prashnts/limn/notebooks/cell-test/cell-runs.png

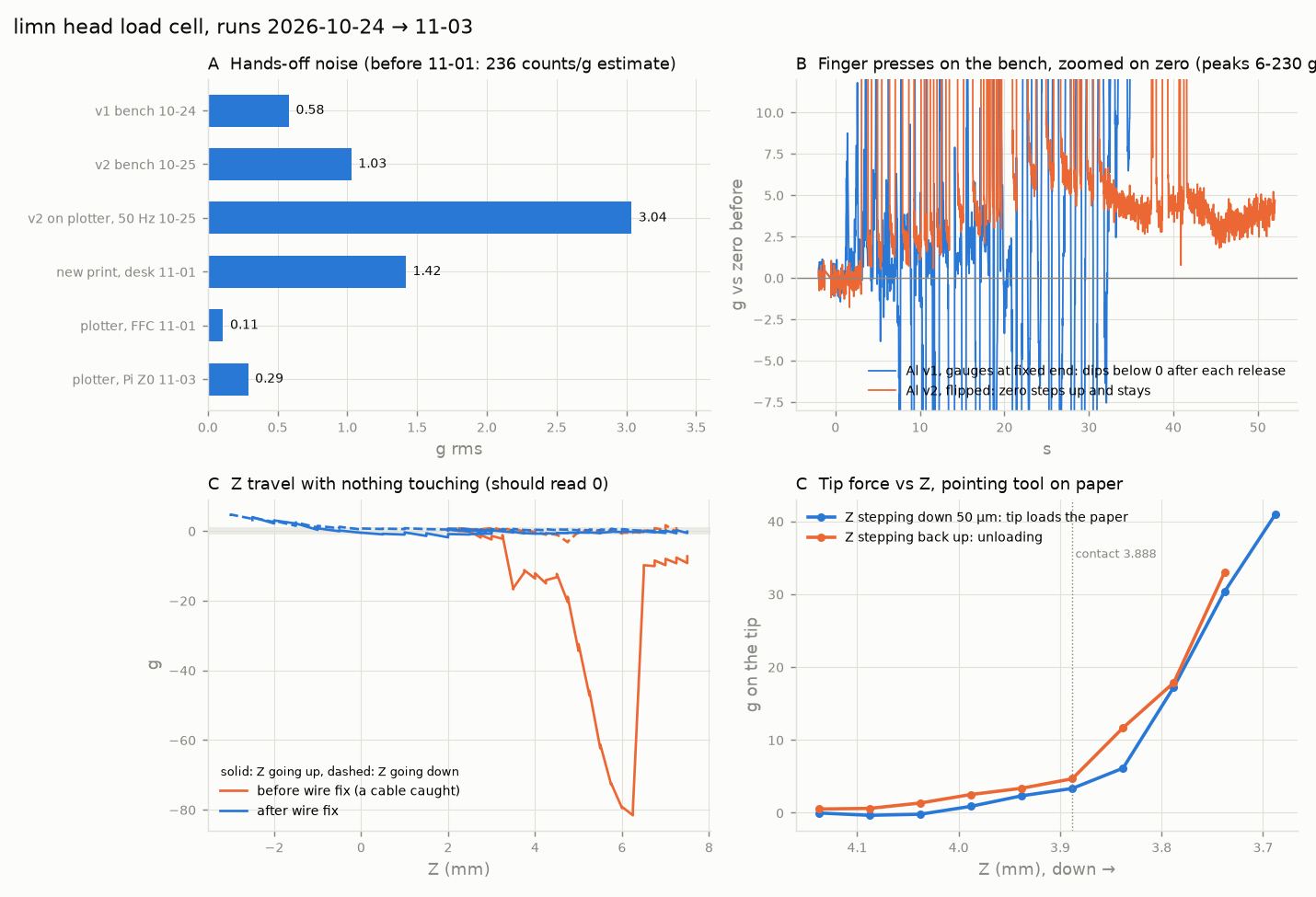
notebooks/cell-test/cell-runs.png
