prashnts/limn/docs/kicad/limn.kicad_pcb

## KiCad design docs/kicad/limn.kicad_pcb (2026-11-08)

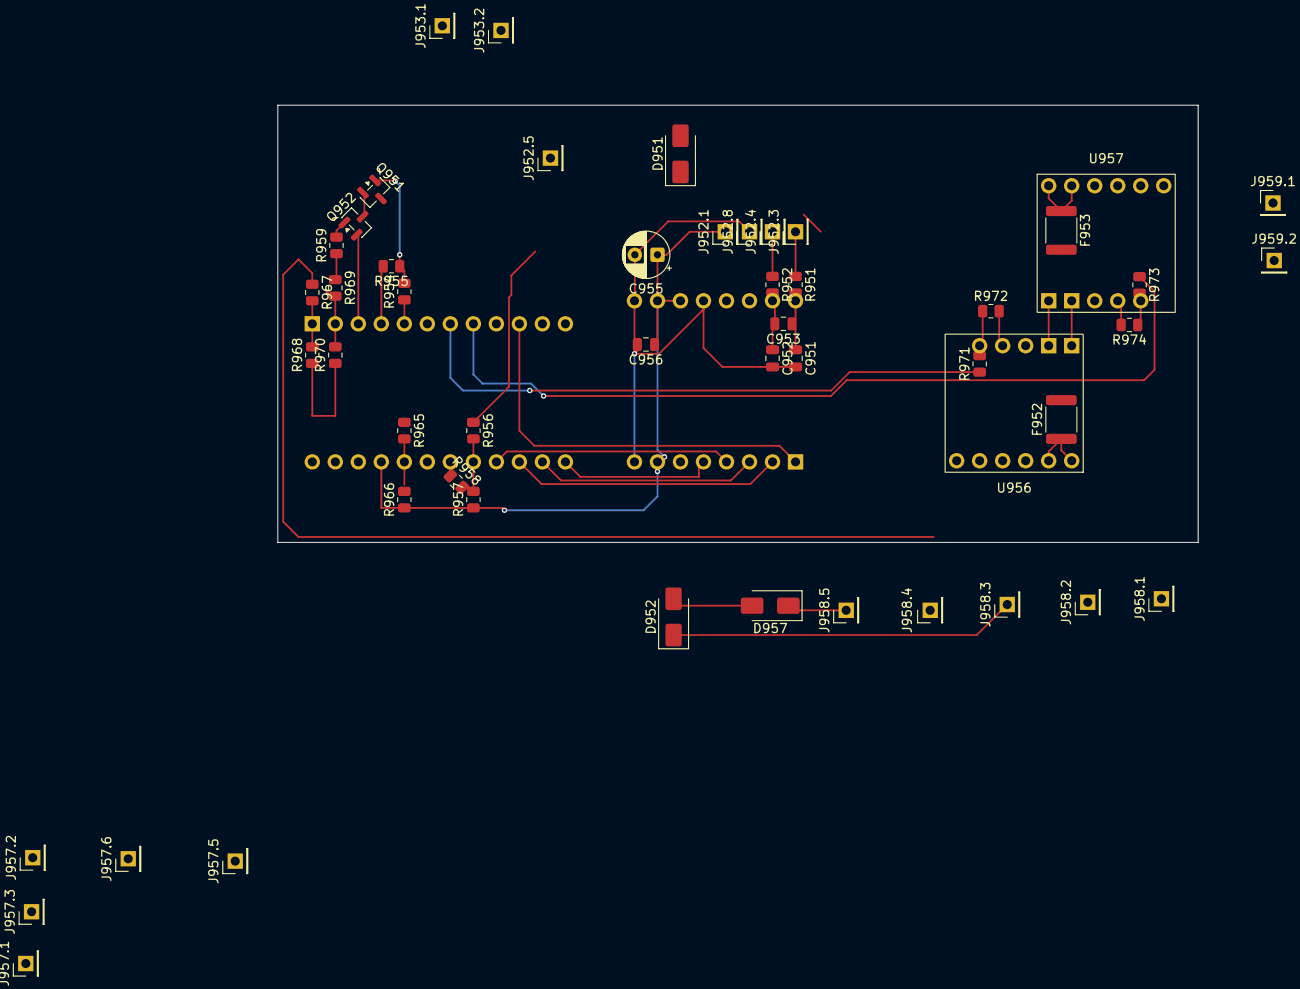
[picture p15: board limn.kicad_pcb from above]

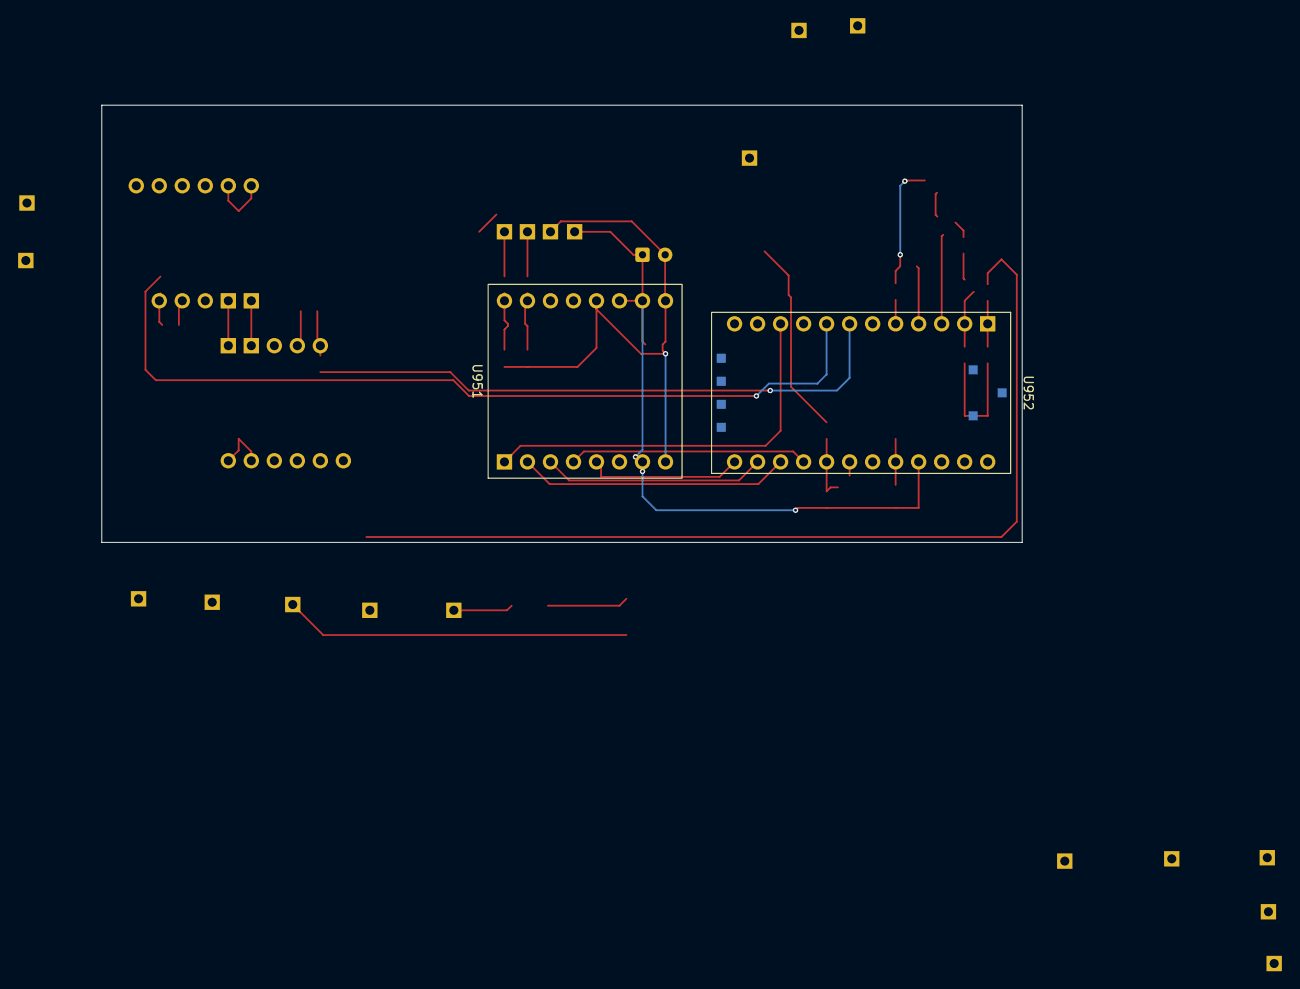
[picture p16: board limn.kicad_pcb from below]

Board: 2 copper layers, 101.6 x 48.3 mm, 53 parts (2 on the bottom side), 37 nets.

Parts:
C951, C952: 4n7 C0G; C_0805_2012Metric
C953: 47n; C_0805_2012Metric
C955: 47u; CP_Radial_D5.0mm_P2.50mm
C956: 100n; C_0805_2012Metric
D951, D952, D957: SMAJ3.3A; D_SMA
F952, F953: PPTC 1812 1A 6V; Fuse_1812_4532Metric
J952.1: CAT6 1; PinHeader_1x01_P2.54mm_Vertical
J952.3: CAT6 3; PinHeader_1x01_P2.54mm_Vertical
J952.4: CAT6 4; PinHeader_1x01_P2.54mm_Vertical
J952.5: CAT6 5; PinHeader_1x01_P2.54mm_Vertical
J952.8: CAT6 8; PinHeader_1x01_P2.54mm_Vertical
J953.1: to the Melzi (EXT A4) 1; PinHeader_1x01_P2.54mm_Vertical
J953.2: to the Melzi (EXT A4) 2; PinHeader_1x01_P2.54mm_Vertical
J957.1: to the hub board (J1002) 1; PinHeader_1x01_P2.54mm_Vertical
J957.2: to the hub board (J1002) 2; PinHeader_1x01_P2.54mm_Vertical
J957.3: to the hub board (J1002) 3; PinHeader_1x01_P2.54mm_Vertical
J957.5: to the hub board (J1002) 5; PinHeader_1x01_P2.54mm_Vertical
J957.6: to the hub board (J1002) 6; PinHeader_1x01_P2.54mm_Vertical
J958.1: to the bed dock (pogo) 1; PinHeader_1x01_P2.54mm_Vertical
J958.2: to the bed dock (pogo) 2; PinHeader_1x01_P2.54mm_Vertical
J958.3: to the bed dock (pogo) 3; PinHeader_1x01_P2.54mm_Vertical
J958.4: to the bed dock (pogo) 4; PinHeader_1x01_P2.54mm_Vertical
J958.5: to the bed dock (pogo) 5; PinHeader_1x01_P2.54mm_Vertical
J959.1: +5V Toolchanger USB 1; PinHeader_1x01_P2.54mm_Vertical
J959.2: +5V Toolchanger USB 2; PinHeader_1x01_P2.54mm_Vertical
Q951: MMBT3904 / BC847 (SOT-23); SOT-23
Q952: AO3400; SOT-23
R951, R952, R958, R959, R971, R973: 1k; R_0805_2012Metric
R954, R968: 4k7; R_0805_2012Metric
R955, R972, R974: 100k; R_0805_2012Metric
R956, R965, R967, R969: 100R; R_0805_2012Metric
R957, R966, R970: 10k; R_0805_2012Metric
U951: ADS1220 module (the sum chip); ADS1220_module
U952: SparkFun Pro Micro RP2040 (top view, USB-C up); SparkFun_Pro_Micro_RP2040
U956, U957: Pololu mini slide sw. #2810; Pololu_Mini_MOSFET_Slide_Switch

Connections:
+3V3_PH: C955.1, C956.1, J952.1.1, R957.1, R966.1, R968.1, R970.1, U951.7 (DVDD), U951.10 (AVDD), U951.11 (REFP0), U952.16 (3V3)
+5V_HUB: J957.1.1, U952.13 (RAW)
+5V_SW: F953.2, J959.1.1
+5V_TOOL_IN: J957.5.1, U956.1 (VIN), U957.1 (VIN)
/Plot bed board/AIN_N: C952.1, C953.2, R952.2, U951.15 (AIN1)
/Plot bed board/AIN_P: C951.1, C953.1, R951.2, U951.16 (AIN0)
/Plot bed board/CIPO: U951.2 (MISO), U952.22 (GP20/CIPO)
/Plot bed board/COPI: U951.3 (MOSI), U952.23 (GP23/COPI)
/Plot bed board/CS2: U951.5 (CS), U952.24 (GP21/CS)
/Plot bed board/DRDY2: U951.1 (DRDY), U952.10 (GP7)
/Plot bed board/ID_PU: R958.1, U952.19 (GP27/A1)
/Plot bed board/SCK: U951.4 (SCLK), U952.21 (GP22/SCK)
/Plot bed board/SIG_N: J952.4.1, R952.1
/Plot bed board/SIG_P: J952.3.1, R951.1
/Plot bed board/TOOL_ID_IN: R956.2, R957.2, R958.2, U952.20 (GP26/A0)
/Plot bed board/TOUCH_GP: R954.1, U952.5 (GP2)
BED_DATA: J958.4.1, R967.1
BED_DETECT: D952.1 (A1), J958.3.1, R965.1
BED_DET_IN: R965.2, R966.2, U952.17 (GP29/A3)
BED_EN: R971.1, U952.7 (GP4)
BED_IO: R967.2, R968.2, U952.1 (GP0/TX)
BED_PROBE: D957.1 (A1), J958.5.1, R959.1, R969.1
BED_PROBE_IN: R969.2, R970.2, U952.2 (GP1/RX)
BED_PWR: F952.2, J958.1.1
GND: C951.2, C952.2, C955.2, C956.2, D951.2 (A2), D952.2 (A2), D957.2 (A2), J952.8.1, J953.2.1, J957.6.1, J958.2.1, J959.2.1, Q952.2 (S), R955.2, R972.2, R974.2, U951.8 (DGND), U951.9 (AGND), U951.12 (REFN0), U952.3 (GND), U952.4 (GND), U952.14 (GND), U956.3 (GND), U957.3 (GND)
unnamed: Q951.1 (B), R954.2, R955.1
unnamed: Q951.2 (E), Q952.3 (D)
unnamed: Q952.1 (G), R959.2
unnamed: R971.2, R972.1, U956.2 (ON)
unnamed: F952.1, U956.4 (VOUT)
unnamed: R973.2, R974.1, U957.2 (ON)
unnamed: F953.1, U957.4 (VOUT)
PM_USB_DN: J957.3.1, U952.31 (D-)
PM_USB_DP: J957.2.1, U952.30 (D+)
PROBE_A4: J953.1.1, Q951.3 (C)
SW_5V_EN: R973.1, U952.8 (GP5)
TOOL_ID: D951.1 (A1), J952.5.1, R956.1
