prashnts/limn/docs/kicad/toolhead_board.kicad_pcb

## KiCad design docs/kicad/toolhead_board.kicad_pcb (2026-11-05)

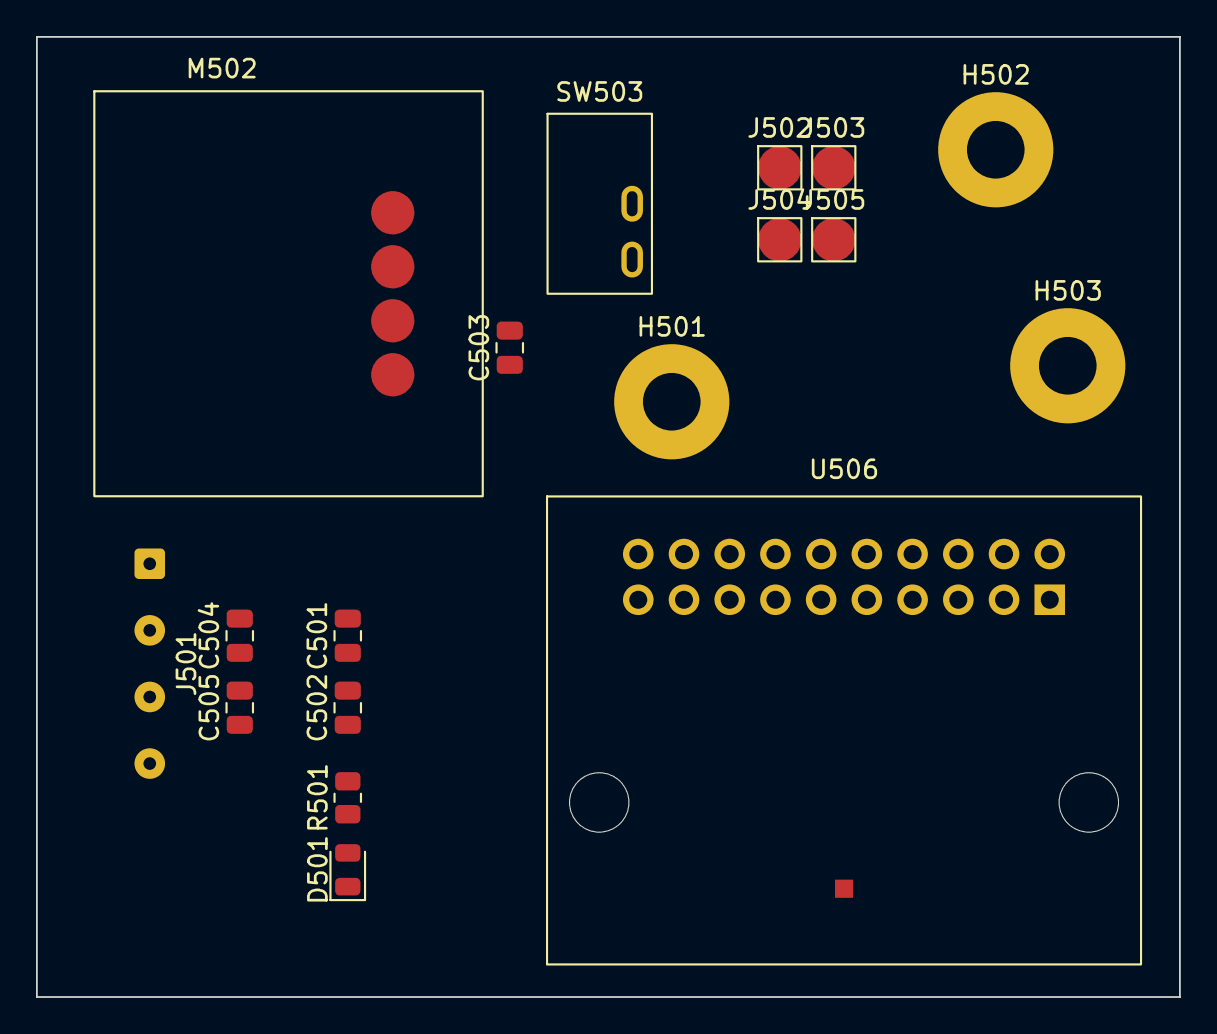
[picture p17: board toolhead_board.kicad_pcb from above]

Board: 2 copper layers, 63.5 x 53.3 mm, 18 parts (0 on the bottom side), 15 nets, no tracks yet.

Parts:
C501: 10u; C_0805_2012Metric
C502, C505: 100n; C_0805_2012Metric
C503: 10n; C_0805_2012Metric
C504: 10n C0G; C_0805_2012Metric
D501: LED yellow; LED_0805_2012Metric
H501: screw right, 5V; MountingHole_3.2mm_M3_Pad
H502: screw left, GND; MountingHole_3.2mm_M3_Pad
H503: screw top, ID; MountingHole_3.2mm_M3_Pad
J501: cell pads; SolderWire-0.127sqmm_1x04_P3.7mm_D0.48mm_OD1mm
J502, J503, J504, J505: pogo; Pogo_pin_D2.0_L5.0
M502: 10 mm linear micro stepper (K, the key lock); Stepper_slider_5mm_flex4
R501: 4k7; R_0805_2012Metric
SW503: key switch (K); Micro_limit_sw_inline
U506: FPC-20P breakout (head); FPC20_breakout

Connections:
+5V_TOOL: C501.1, C502.1, H501.1, R501.1, U506.13, U506.14, U506.15
CELL_EXC_N: C505.2, J501.4, U506.5
CELL_EXC_P: C505.1, J501.1, U506.2
CELL_SIG_N: C504.2, J501.3, U506.4
CELL_SIG_P: C504.1, J501.2, U506.3
ENDSTOP_K: C503.1, SW503.1, U506.7
GND: C501.2, C502.2, C503.2, D501.1, H502.1, J504.1, SW503.2, U506.1, U506.6, U506.8, U506.11, U506.16
MOT_K_1A: M502.1, U506.17
MOT_K_1B: M502.2, U506.18
MOT_K_2A: M502.3, U506.19
MOT_K_2B: M502.4, U506.20
unnamed: D501.2, R501.2
TOOL_ID: H503.1, J505.1, U506.12
TOOL_USB_DN: J503.1, U506.10
TOOL_USB_DP: J502.1, U506.9
