prashnts/limn/docs/kicad/aux_board.kicad_pcb

## KiCad design docs/kicad/aux_board.kicad_pcb (2026-10-24)

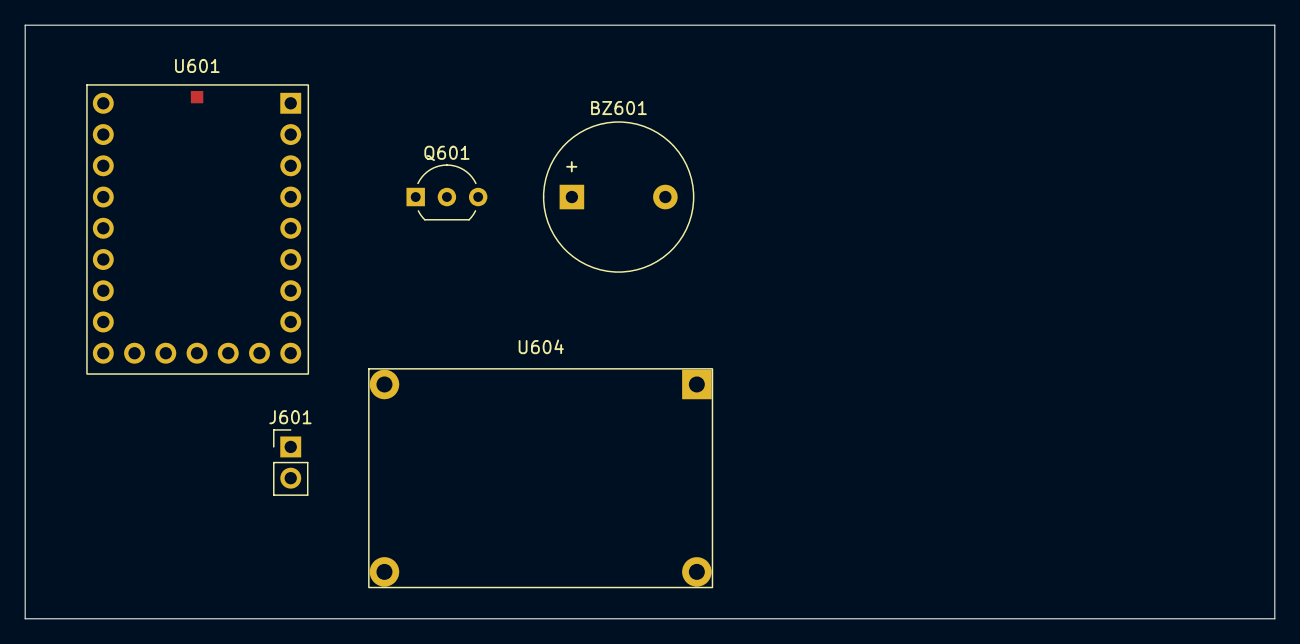
[picture p18: board aux_board.kicad_pcb from above]

Board: 2 copper layers, 101.6 x 48.3 mm, 5 parts (0 on the bottom side), 5 nets, no tracks yet.

Parts:
BZ601: buzzer; Buzzer_12x9.5RM7.6
J601: 9 V in (Trigger1); PinHeader_1x02_P2.54mm_Vertical
Q601: 2N7000; TO-92_Inline_Wide
U601: RP2040-Zero (rpi); Waveshare_RP2040_Zero
U604: MP1495 5 V (MP_Buck0); Mini_buck_3A

Connections:
+5V_LED: BZ601.1, U601.23, U604.3
+9V: J601.1, U604.1
GND: J601.2, Q601.1, U601.22, U604.2, U604.4
unnamed: BZ601.2, Q601.3
unnamed: Q601.2, U601.10
