prashnts/limn/docs/kicad/beam_bed_board.kicad_pcb

## KiCad design docs/kicad/beam_bed_board.kicad_pcb (2026-10-24)

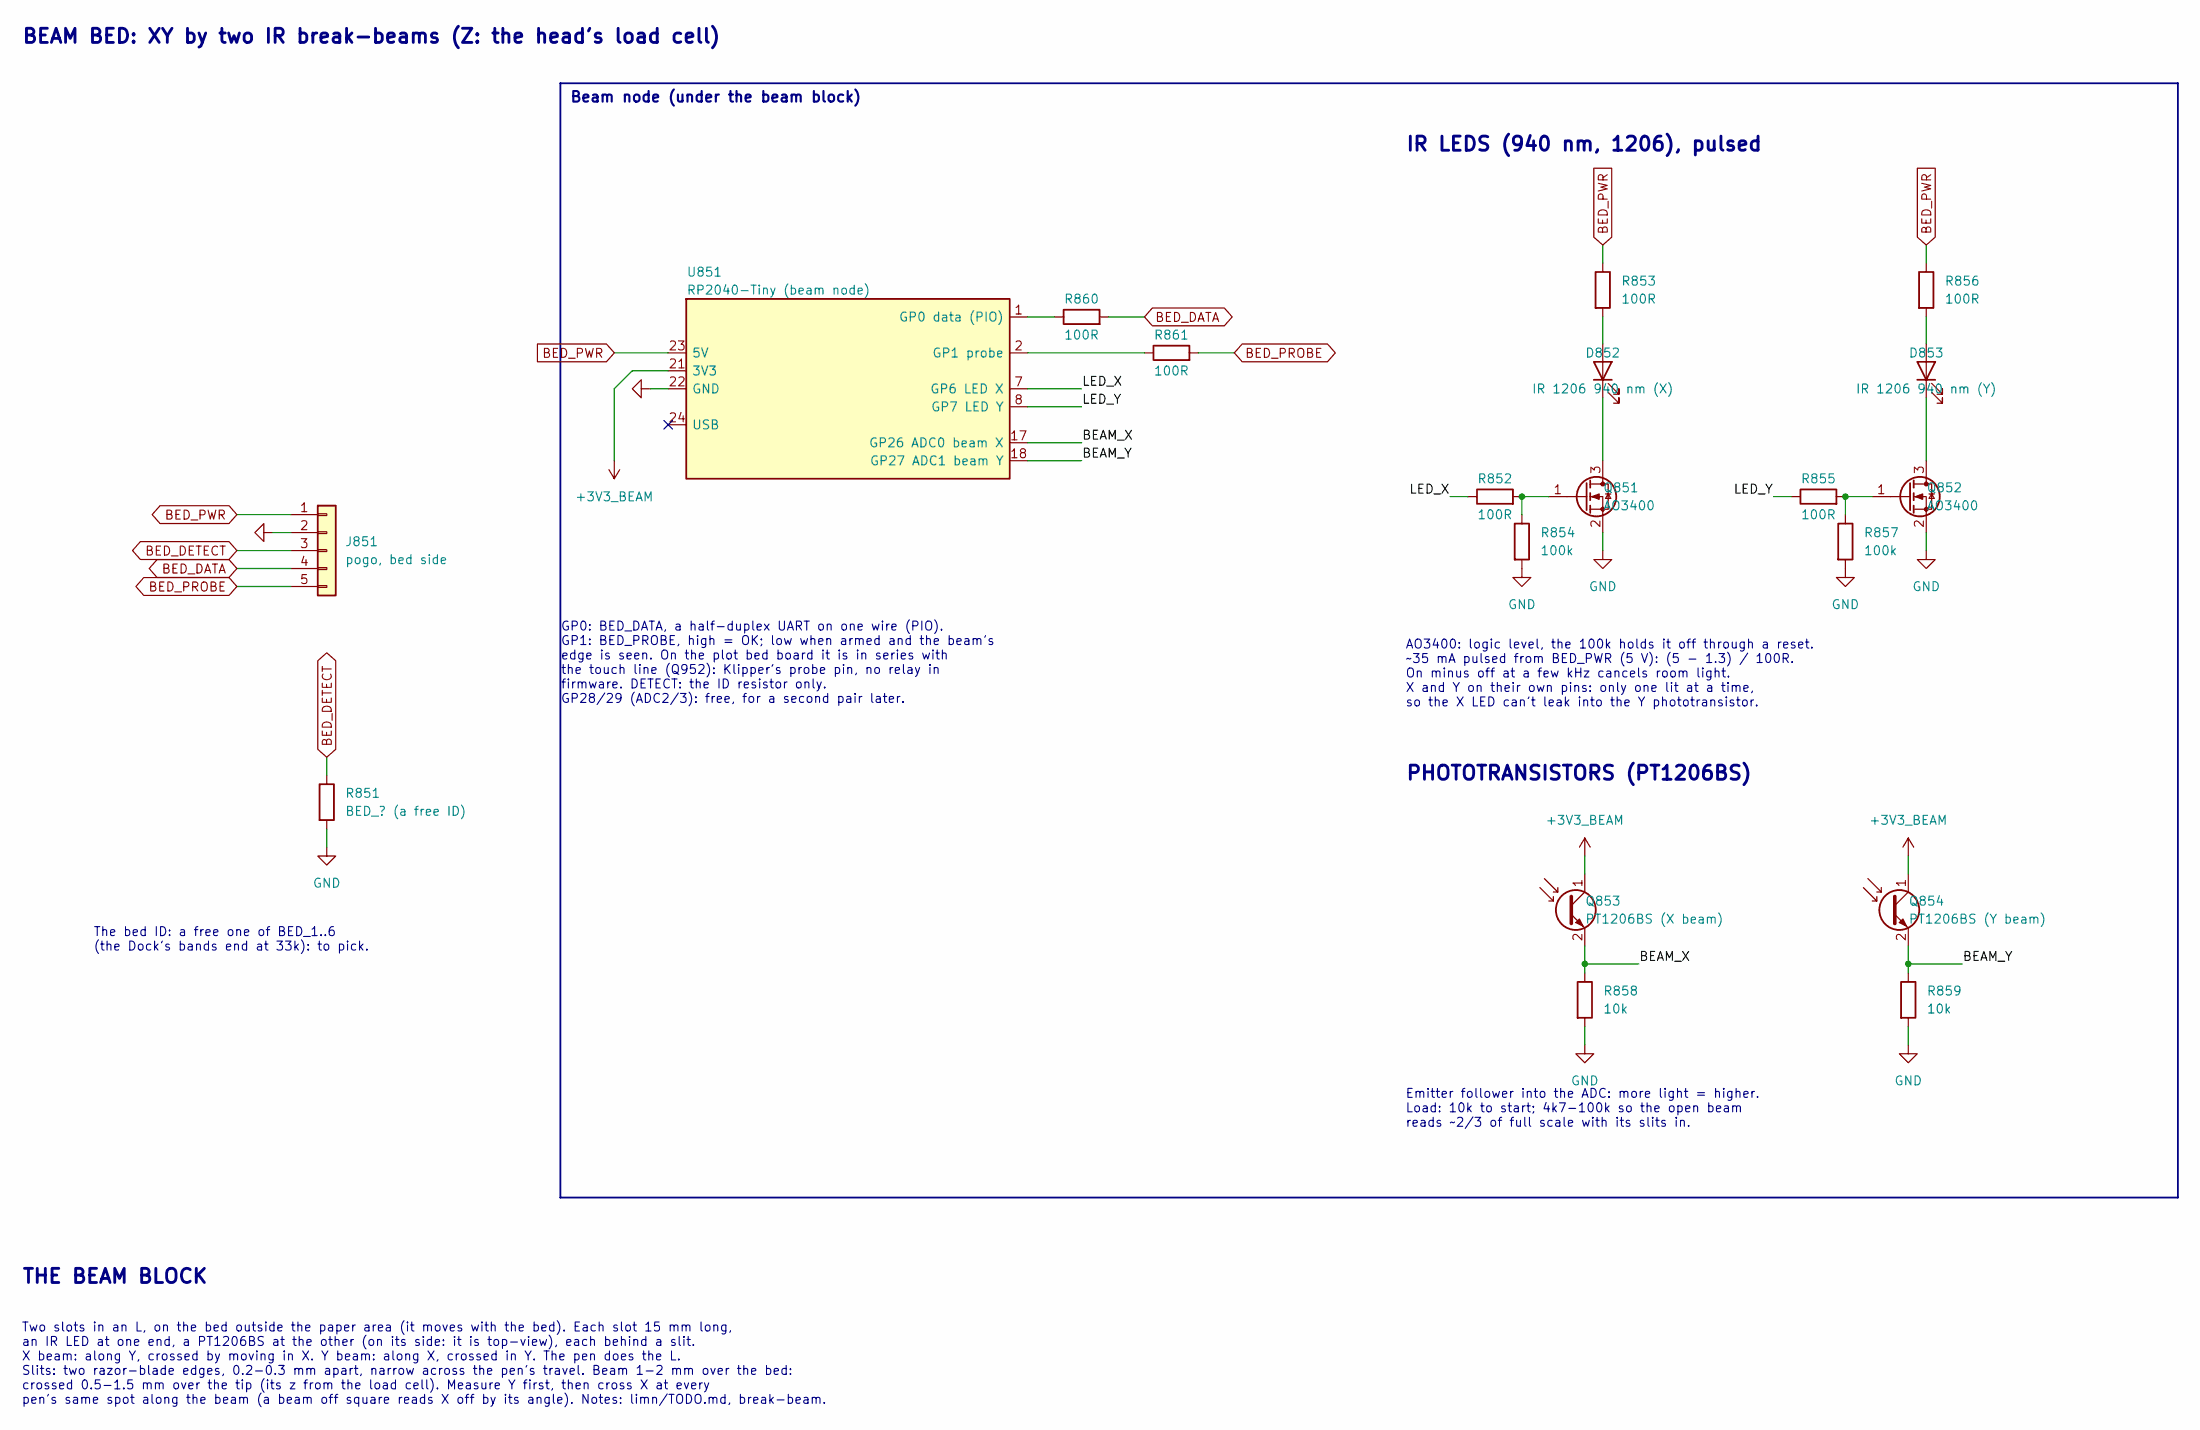
[picture p19: schematic beam_bed.kicad_sch, Limn: the beam bed, XY by two IR break-beams]

Parts:
D852: IR 1206 940 nm (X); LED_1206_3216Metric
D853: IR 1206 940 nm (Y); LED_1206_3216Metric
J851: pogo, bed side; PinHeader_1x05_P2.54mm_Vertical
Q851, Q852: AO3400; SOT-23
Q853: PT1206BS (X beam); LED_1206_3216Metric
Q854: PT1206BS (Y beam); LED_1206_3216Metric
R851: BED_? (a free ID); R_0805_2012Metric
R852, R853, R855, R856, R860, R861: 100R; R_0805_2012Metric
R854, R857: 100k; R_0805_2012Metric
R858, R859: 10k; R_0805_2012Metric
U851: RP2040-Tiny (beam node); Waveshare_RP2040_Tiny

Connections:
+3V3_BEAM: Q853.1 (C), Q854.1 (C), U851.21 (3V3)
/Beam bed (XY)/BEAM_X: Q853.2 (E), R858.1, U851.17 (GP26 ADC0 beam X)
/Beam bed (XY)/BEAM_Y: Q854.2 (E), R859.1, U851.18 (GP27 ADC1 beam Y)
/Beam bed (XY)/LED_X: R852.1, U851.7 (GP6 LED X)
/Beam bed (XY)/LED_Y: R855.1, U851.8 (GP7 LED Y)
BED_DATA: J851.4, R860.2
BED_DETECT: J851.3, R851.1
BED_PROBE: J851.5, R861.2
BED_PWR: J851.1, R853.1, R856.1, U851.23 (5V)
GND: J851.2, Q851.2 (S), Q852.2 (S), R851.2, R854.2, R857.2, R858.2, R859.2, U851.22 (GND)
unnamed: D852.2 (A), R853.2
unnamed: D852.1 (K), Q851.3 (D)
unnamed: D853.2 (A), R856.2
unnamed: D853.1 (K), Q852.3 (D)
unnamed: Q851.1 (G), R852.2, R854.1
unnamed: Q852.1 (G), R855.2, R857.1
unnamed: R860.1, U851.1 (GP0 data (PIO))
unnamed: R861.1, U851.2 (GP1 probe)

Notes on the sheet:
BEAM BED: XY by two IR break-beams (Z: the head's load cell)
The bed ID: a free one of BED_1..6 (the Dock's bands end at 33k): to pick.
GP0: BED_DATA, a half-duplex UART on one wire (PIO). GP1: BED_PROBE, high = OK; low when armed and the beam's edge is seen. On the plot bed board it is in series with the touch line (Q952): Klipper's probe pin, no relay in firmware. DETECT: the ID resistor only. GP28/29 (ADC2/3): free, for a second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
IR LEDS (940 nm, 1206), pulsed
AO3400: logic level, the 100k holds it off through a reset. ~35 mA pulsed from BED_PWR (5 V): (5 - 1.3) / 100R. On minus off at a few kHz cancels room light. X and Y on their own pins: only one lit at a time, so the X LED can't leak into the Y phototransistor.
PHOTOTRANSISTORS (PT1206BS)
Emitter follower into the ADC: more light = higher. Load: 10k to start; 4k7-100k so the open beam reads ~2/3 of full scale with its slits in.
Beam node (under the beam block)
THE BEAM BLOCK
Two slots in an L, on the bed outside the paper area (it moves with the bed). Each slot 15 mm long, an IR LED at one end, a PT1206BS at the other (on its side: it is top-view), each behind a slit. X beam: along Y, crossed by moving in X. Y beam: along X, crossed in Y. The pen does the L. Slits: two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

Board: 2 copper layers, 19 parts (0 on the bottom side), 18 nets, no tracks yet.
