prashnts/limn/docs/kicad/hub_board.kicad_pcb

## KiCad design docs/kicad/hub_board.kicad_pcb (2026-10-24)

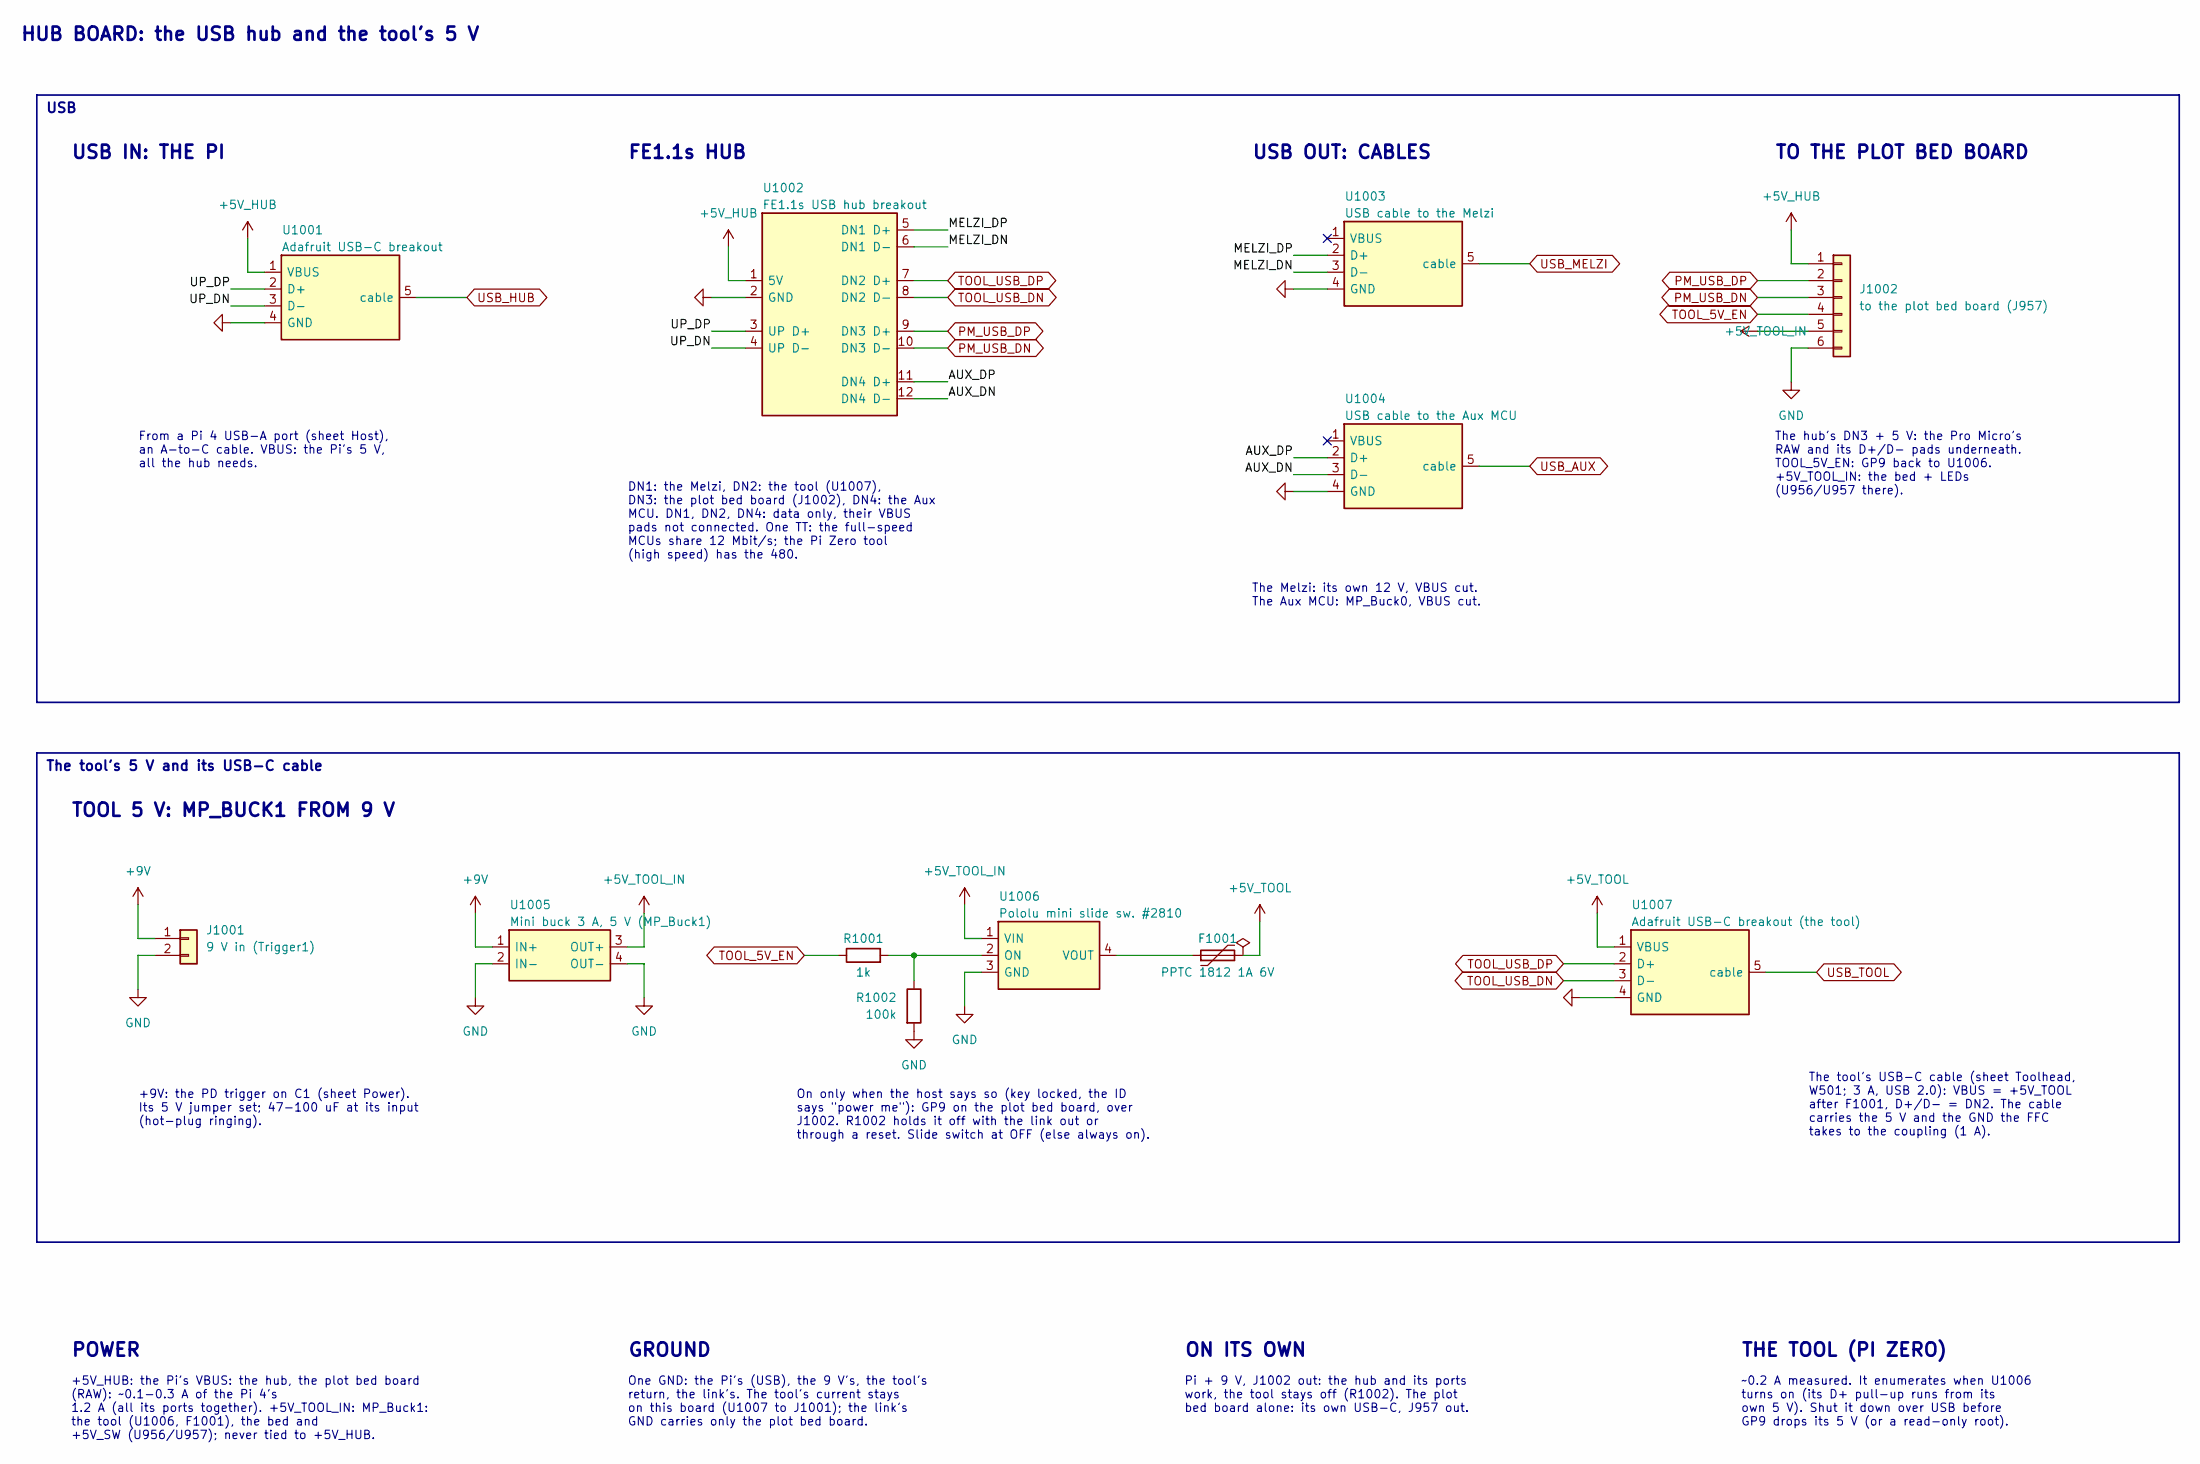
[picture p20: schematic hub.kicad_sch, Limn: the hub board, USB hub + the tool's 5 V]

Parts:
F1001: PPTC 1812 1A 6V; Fuse_1812_4532Metric
J1001: 9 V in (Trigger1); PinHeader_1x02_P2.54mm_Vertical
J1002: to the plot bed board (J957); PinHeader_1x06_P2.54mm_Vertical
R1001: 1k; R_0805_2012Metric
R1002: 100k; R_0805_2012Metric
U1001: Adafruit USB-C breakout; Adafruit_USB_C_breakout
U1002: FE1.1s USB hub breakout; FE1.1s_USB_hub_breakout
U1003: USB cable to the Melzi; USB_cable_pads
U1004: USB cable to the Aux MCU; USB_cable_pads
U1005: Mini buck 3 A, 5 V (MP_Buck1); Mini_buck_3A
U1006: Pololu mini slide sw. #2810; Pololu_Mini_MOSFET_Slide_Switch
U1007: Adafruit USB-C breakout (the tool); Adafruit_USB_C_breakout

Connections:
+5V_HUB: J1002.1, U1001.1 (VBUS), U1002.1 (5V)
+5V_TOOL: F1001.2, U1007.1 (VBUS); also elsewhere on the board
+5V_TOOL_IN: J1002.5, U1005.3 (OUT+), U1006.1 (VIN)
+9V: J1001.1, U1005.1 (IN+)
/Hub board (USB + tool 5 V)/AUX_DN: U1002.12 (DN4 D-), U1004.3 (D-)
/Hub board (USB + tool 5 V)/AUX_DP: U1002.11 (DN4 D+), U1004.2 (D+)
/Hub board (USB + tool 5 V)/MELZI_DN: U1002.6 (DN1 D-), U1003.3 (D-)
/Hub board (USB + tool 5 V)/MELZI_DP: U1002.5 (DN1 D+), U1003.2 (D+)
/Hub board (USB + tool 5 V)/UP_DN: U1001.3 (D-), U1002.4 (UP D-)
/Hub board (USB + tool 5 V)/UP_DP: U1001.2 (D+), U1002.3 (UP D+)
GND: J1001.2, J1002.6, R1002.2, U1001.4 (GND), U1002.2 (GND), U1003.4 (GND), U1004.4 (GND), U1005.2 (IN-), U1005.4 (OUT-), U1006.3 (GND), U1007.4 (GND); also elsewhere on the board
unnamed: R1001.2, R1002.1, U1006.2 (ON)
unnamed: F1001.1, U1006.4 (VOUT)
PM_USB_DN: J1002.3, U1002.10 (DN3 D-)
PM_USB_DP: J1002.2, U1002.9 (DN3 D+)
TOOL_5V_EN: J1002.4, R1001.1
TOOL_USB_DN: U1002.8 (DN2 D-), U1007.3 (D-); also elsewhere on the board
TOOL_USB_DP: U1002.7 (DN2 D+), U1007.2 (D+); also elsewhere on the board
USB_AUX: U1004.5 (cable)
USB_HUB: U1001.5 (cable)
USB_MELZI: U1003.5 (cable)

Notes on the sheet:
HUB BOARD: the USB hub and the tool's 5 V
USB IN: THE PI
From a Pi 4 USB-A port (sheet Host), an A-to-C cable. VBUS: the Pi's 5 V, all the hub needs.
FE1.1s HUB
DN1: the Melzi, DN2: the tool (U1007), DN3: the plot bed board (J1002), DN4: the Aux MCU. DN1, DN2, DN4: data only, their VBUS pads not connected. One TT: the full-speed MCUs share 12 Mbit/s; the Pi Zero tool (high speed) has the 480.
USB OUT: CABLES
The Melzi: its own 12 V, VBUS cut. The Aux MCU: MP_Buck0, VBUS cut.
TO THE PLOT BED BOARD
The hub's DN3 + 5 V: the Pro Micro's RAW and its D+/D- pads underneath. TOOL_5V_EN: GP9 back to U1006. +5V_TOOL_IN: the bed + LEDs (U956/U957 there).
USB
TOOL 5 V: MP_BUCK1 FROM 9 V
+9V: the PD trigger on C1 (sheet Power). Its 5 V jumper set; 47-100 uF at its input (hot-plug ringing).
On only when the host says so (key locked, the ID says "power me"): GP9 on the plot bed board, over J1002. R1002 holds it off with the link out or through a reset. Slide switch at OFF (else always on).
The tool's USB-C cable (sheet Toolhead, W501; 3 A, USB 2.0): VBUS = +5V_TOOL after F1001, D+/D- = DN2. The cable carries the 5 V and the GND the FFC takes to the coupling (1 A).
The tool's 5 V and its USB-C cable
POWER
+5V_HUB: the Pi's VBUS: the hub, the plot bed board (RAW): ~0.1-0.3 A of the Pi 4's 1.2 A (all its ports together). +5V_TOOL_IN: MP_Buck1: the tool (U1006, F1001), the bed and +5V_SW (U956/U957); never tied to +5V_HUB.
GROUND
One GND: the Pi's (USB), the 9 V's, the tool's return, the link's. The tool's current stays on this board (U1007 to J1001); the link's GND carries only the plot bed board.
ON ITS OWN
Pi + 9 V, J1002 out: the hub and its ports work, the tool stays off (R1002). The plot bed board alone: its own USB-C, J957 out.
THE TOOL (PI ZERO)
~0.2 A measured. It enumerates when U1006 turns on (its D+ pull-up runs from its own 5 V). Shut it down over USB before GP9 drops its 5 V (or a read-only root).

Board: 2 copper layers, 12 parts (0 on the bottom side), 18 nets, no tracks yet.

Other parts of the board:
J1003: CAT6 #2 (to the tool); PinHeader_1x08_P2.54mm_Vertical

Their connections:
+5V_TOOL: J1003.1, J1003.2, J1003.3; also elsewhere on the board
GND: J1003.6, J1003.7, J1003.8; also elsewhere on the board
TOOL_USB_DN: J1003.5; also elsewhere on the board
TOOL_USB_DP: J1003.4; also elsewhere on the board
