prashnts/limn/klipper/limn.cfg

# Half speed: more torque near the "just clamped" point of the coupling screws
[gcode_macro K_LOCK]
gcode:
  MANUAL_STEPPER STEPPER=axis_k ENABLE=1 SET_POSITION=0 MOVE=16 SPEED=5
  _K_REPORT
  _BUZZ_ACT
  MANUAL_STEPPER STEPPER=axis_k ENABLE=0
  _BUZZ_K_LOCK
  SET_LED_EFFECT EFFECT=ui_key_locked REPLACE=1

# The new rack (2026-11-07) has a notch: the switch's state at each end is still to be
# learned, so this only reports it
[gcode_macro _K_REPORT]
gcode:
  QUERY_ENDSTOPS
  _K_REPORT_1

[gcode_macro _K_REPORT_1]
gcode:
  M118 [K] switch {'triggered' if printer.query_endstops.last_query['manual_stepper axis_k'] else 'open'}

[gcode_macro K_LOCK_UNLOCK_LOCK]
gcode:
  MANUAL_STEPPER STEPPER=axis_k ENABLE=1 SET_POSITION=0 MOVE=10
  _BUZZ_ACT
  MANUAL_STEPPER STEPPER=axis_k ENABLE=1 SET_POSITION=16 MOVE=8
  _BUZZ_ACT
  MANUAL_STEPPER STEPPER=axis_k ENABLE=1 SET_POSITION=0 MOVE=16
  _BUZZ_ACT
  MANUAL_STEPPER STEPPER=axis_k ENABLE=0
  _BUZZ_K_LOCK
  SET_LED_EFFECT EFFECT=ui_key_locked REPLACE=1

# The head's pogo pins push the tool off: unlocked outside a holder, a carried tool
# falls. So K_UNLOCK refuses while one is carried, unless IN_HOLDER=1 (_DOCK_TOOL).
[gcode_macro K_UNLOCK]
gcode:
  {% set carried = printer.save_variables.variables.currently_docked_tool|default(0)|int %}
  {% if (carried or printer.limn.manual) and not params.IN_HOLDER|default(0)|int %}
    { action_raise_error("K_UNLOCK: tool %s is carried; unlock only in its holder" % carried) }
  {% endif %}
  # K_LOCK's 16 back, same speed (2026-11-07: new rack, no overdrive)
  MANUAL_STEPPER STEPPER=axis_k ENABLE=1 SET_POSITION=16 MOVE=0 SPEED=5
  _K_REPORT
  _BUZZ_ACT
  MANUAL_STEPPER STEPPER=axis_k ENABLE=0
  _BUZZ_K_UNLOCK
  SET_LED_EFFECT EFFECT=ui_key_unlocked REPLACE=1


[gcode_macro LAZY_HOME]
gcode:
  {% if printer.toolhead.homed_axes != "xyz" %}
    G28
  {% endif %}

[gcode_macro BED_MESH_CALIBRATE]
rename_existing: BED_MESH_CALIBRATE_0
gcode:
  G28 Z
  UNDOCK
  G1 X65 Y45
  BED_MESH_CALIBRATE_0 {rawparams}
  _BUZZ_ACT

[gcode_macro PROBE_ACCURACY]
rename_existing: PROBE_ACCURACY_0
gcode:
  LAZY_HOME
  PROBE_ACCURACY_0 {raw_params}

# Up, with the offsets still on: a tag dz over 2 (T1's Micron, 2026-09-30) takes
# Z8 past position_max 10, so never higher than 9.5 less the Z offset applied.
[gcode_macro _SAFE_OFFSET_HOME]
gcode:
  {% set gcode_x = printer.gcode_move.gcode_position.x|float %}
  {% set gcode_y = printer.gcode_move.gcode_position.y|float %}
  {% set recenter = params.HOME|default(0)|int %}
  {% set z_room = 9.5 - printer.gcode_move.homing_origin.z|float %}
  G1 F4500
  {% if recenter %}
    G1 Z{[8, z_room]|min}
    G1 X42 Y123
  {% else %}
    G1 Z{[7, z_room]|min}
    {% if gcode_y < 5 %}
      G1 Y5
    {% endif %}
    {% if gcode_x < 5 %}
      G1 X5
    {% endif %}
  {% endif %}

[gcode_macro _APPLY_OFFSETS]
gcode:
  {% set mesh_profile = printer.bed_mesh.profile_name %}
  {% set svv = printer.save_variables.variables %}
  {% set offset_x = svv.tool_offset_x|default(0)|float %}
  {% set offset_y = svv.tool_offset_y|default(0)|float %}
  {% set offset_z = svv.tool_offset_z|default(0)|float %}
  {% set last_mesh_profile = svv.last_mesh_profile %}
  {% set recenter = params.HOME|default(0)|int %}
  {% set mesh_name_override = params.MESH if 'MESH' in params else last_mesh_profile %}

  _SAFE_OFFSET_HOME HOME={recenter}

  SET_GCODE_OFFSET X=0 Y=0 Z=0 MOVE=1
  BED_MESH_OFFSET X=0 Y=0
  # MOVE=1 lifts Z by the dz: first low enough that it stays under position_max
  G1 Z{[8, 9.5 - offset_z]|min}
  SET_GCODE_OFFSET X={offset_x} Y={offset_y} Z={offset_z} MOVE=1

  G1 Z7

  M118 Would load mesh: {mesh_name_override}
  {% if mesh_name_override %}
    BED_MESH_PROFILE LOAD={mesh_name_override}
    BED_MESH_OFFSET X={offset_x} Y={offset_y}
    SAVE_VARIABLE VARIABLE=last_mesh_profile VALUE='"{mesh_name_override}"'
  {% endif %}
  _BUZZ_ACT

[gcode_macro _CLEAR_OFFSETS]
gcode:
  {% set recenter = params.HOME|default(0)|int %}
  {% set mesh_profile = printer.bed_mesh.profile_name %}
  _SAFE_OFFSET_HOME HOME={recenter}

  {% if mesh_profile %}
    SAVE_VARIABLE VARIABLE=last_mesh_profile VALUE='"{mesh_profile}"'
    BED_MESH_CLEAR
    M118 Cleared mesh
  {% endif %}
  BED_MESH_OFFSET X=0 Y=0
  SET_GCODE_OFFSET X=0 Y=0 Z=0 MOVE=1
  M118 Offset Cleared
  _BUZZ_WARN


[gcode_macro G28]
rename_existing: G28.1
gcode:
  {% set has_axes = 'X' in params or 'Y' in params or 'Z' in params %}

  {% if has_axes %}
    G28.1 {rawparams}
  {% else %}
    G28.1 Z
    G28.1 X
    G28.1 Y
  {% endif %}
  {% if not has_axes or ('X' in params and 'Y' in params) %}
    SET_GCODE_VARIABLE MACRO=_DOCK_HOME VARIABLE=docks_unhomed VALUE=0
  {% endif %}


[gcode_macro _DOCK_HOME]
description: "Home to Tools"
gcode:
  G1 X{dock_x}
  G1 Z{dock_z}
  G1 Y{dock_x}
variable_dock_z: 7.9
variable_dock_x: 114
variable_dock_y: 13
# Docking can slam the toolhead: after a pickup it homes (HOME=1, what drawing does),
# or with HOME=0 at least every second pickup (scans, tag writes). G28 resets it.
variable_docks_unhomed: 0

variable_tool_41_x: 125
variable_tool_41_y: 16
variable_tool_41_z: 8
variable_tool_41_dx: 51
variable_tool_41_dy: 0
variable_tool_41_dz: 0

variable_tool_42_x: 125
variable_tool_42_y: 56
variable_tool_42_z: 8
variable_tool_42_dx: 51
variable_tool_42_dy: 0
variable_tool_42_dz: 0

variable_tool_43_x: 125
variable_tool_43_y: 96
variable_tool_43_z: 8
variable_tool_43_dx: 51
variable_tool_43_dy: 0
variable_tool_43_dz: 0

variable_tool_44_x: 125
variable_tool_44_y: 136
variable_tool_44_z: 8
variable_tool_44_dx: 51
variable_tool_44_dy: 0
variable_tool_44_dz: 0

variable_tool_45_x: 125
variable_tool_45_y: 176
variable_tool_45_z: 8
variable_tool_45_dx: 51
variable_tool_45_dy: 0
variable_tool_45_dz: 0


[gcode_macro _DOCK_TOOL]
description: Dock/undock given tool. eg. _DOCK_TOOL T=42 ACT=dock|undock|calibrate
gcode:
  {% set tool_id = params['T']|default(42)|int %}
  {% set prefix = "tool_" ~ tool_id ~ "_" %}
  {% set docking = params['ACT'] == 'dock' %}
  {% set calibrate = 15 if params['ACT'] == 'calibrate' else 0 %}
  {% set dh = printer["gcode_macro _DOCK_HOME"] %}
  {% set mesh_profile = printer.bed_mesh.profile_name %}

  # The holder must have the tool to pick up, and be free to return one.
  # The checks and TOOL_CHANGE_PHASE also drive the LEDs, see ext/limn/leds.py.
  {% if docking %}
    TOOL_HOLDER_CHECK T={tool_id} EXPECT=occupied ARM=1
  {% elif params['ACT'] == 'undock' %}
    TOOL_HOLDER_CHECK T={tool_id} EXPECT=empty ARM=1
  {% endif %}

  # SAVE_GCODE_STATE NAME=DOCK_TOOL_state

  G90
  G1 F6000
  M118 {params['ACT']}ing {tool_id}

  _CLEAR_OFFSETS

  # Home to tool
  # {% if docking %}
  #   G28
  # {% else %}
  #   G28 Z
  #   LAZY_HOME
  # {% endif %}
  G1 Z9.2
  G1 F5500
  
  G1 X{dh[prefix + "x"]} Y{dh[prefix + "y"]}
  G1 Z{dh[prefix + "z"]}

  QUERY_ENDSTOPS
  M400
  TOOL_CHANGE_PHASE PHASE=engage
  # Picking up: open for the tool. Returning one: it stays locked until in the holder
  {% if params['ACT'] != 'undock' %}
    K_UNLOCK
  {% endif %}

  # Switch to relative coords
  G91
  
  # Move towards threshold
  G1 Z{dh[prefix + "dz"]}
  G1 Y{dh[prefix + "dy"]}
  G1 X{dh[prefix + "dx"] / 2}
  _BUZZ_ACT

  # Slow down
  G1 F2500
  G1 X{dh[prefix + "dx"] / 2}

  # Dock/undock the tool
  {% if docking %}
    _BUZZ_ACT
    G1 F1500
    # Nudge
    G1 Z0.5 Y-0.5 X-0.5
    G1 X0.5 Y0.5
    G1 Z-0.5
    # The pogo pins push the tool off: lock once, held PUSH mm further in (no
    # unlock in between, it lets the pins shove the tool back)
    {% set push = params.PUSH|default(0.3)|float %}
    G1 X{push}
    K_LOCK
    G1 X-{push}
  {% elif params['ACT'] == 'undock' %}
    K_UNLOCK IN_HOLDER=1
    _BUZZ_ACT
  {% endif %}

  # Move away from threshold
  TOOL_CHANGE_PHASE PHASE=leave
  G1 F2000

  G1 X-{dh[prefix + "dx"]}
  G1 Y-{dh[prefix + "dy"]}

  # Speed up
  G1 F4500
  # G1 F2500
  # End relative motion
  G90

  # Save the carried tool only once the holder confirms the move
  {% if docking %}
    TOOL_HOLDER_CHECK T={tool_id} EXPECT=empty
    SAVE_VARIABLE VARIABLE=currently_docked_tool VALUE={tool_id}
  {% elif params['ACT'] == 'undock' %}
    TOOL_HOLDER_CHECK T={tool_id} EXPECT=occupied
    SAVE_VARIABLE VARIABLE=currently_docked_tool VALUE=0
    SAVE_VARIABLE VARIABLE=tool_offset_x VALUE=0
    SAVE_VARIABLE VARIABLE=tool_offset_y VALUE=0
    SAVE_VARIABLE VARIABLE=tool_offset_z VALUE=0
    SAVE_VARIABLE VARIABLE=tool_name VALUE='""'
  {% endif %}

  {% if docking %}
    # After picking up the tool: out of the holder, so tighten only (an unlock drops it)
    K_LOCK
    RFID_READ
    {% set since = dh.docks_unhomed|int + 1 %}
    {% if params.HOME|default(1)|int or since >= 2 %}
      G28
    {% else %}
      SET_GCODE_VARIABLE MACRO=_DOCK_HOME VARIABLE=docks_unhomed VALUE={since}
      M118 Picked up {tool_id} without homing: the next pickup homes
    {% endif %}
  {% endif %}

  M118 {params['ACT']}ed {tool_id}.
  _BUZZ_ACT

  # RESTORE_GCODE_STATE NAME=DOCK_TOOL_state

# A tool docked by hand (DOCK_MANUAL, printer.limn.manual) has no holder: nothing
# that goes into the dock runs until it is taken off (DOCK_CLEAR, or its tag held
# to the reader again). The extension also keeps the carriage out of the dock.
[gcode_macro _NO_MANUAL_TOOL]
gcode:
  {% if printer.limn.manual %}
    { action_raise_error("A tool docked by hand is on the carriage (" ~ printer.limn.manual.name ~ "): take it off, then DOCK_CLEAR or hold it to the reader") }
  {% endif %}

[gcode_macro DOCK]
description: Dock given tool. eg. DOCK T=42 [K=70..74] [HOME=0: home at least every second pickup]
gcode:
  {% set tool_id = (params.K|int + 1 - 30) if 'T' not in params else params.T|int %}
  {% set svv = printer.save_variables.variables %}
  {% set existing_tool = svv.currently_docked_tool|default(0)|int %}

  _NO_MANUAL_TOOL
  {% if existing_tool == tool_id %}
    _BUZZ_DOOP
    M118 Currently Docked: {tool_id}, reading tag...
    LAZY_HOME
    RFID_READ
    # _APPLY_OFFSETS
  {% else %}
    {% if existing_tool > 0 %}
      # Undock if holding a tool
      M118 Undocking EXT:{existing_tool} before docking NEW:{tool_id}.
      _DOCK_TOOL T={existing_tool} ACT=undock
    {% endif %}

    _DOCK_TOOL T={tool_id} ACT=dock HOME={params.HOME|default(1)|int} PUSH={params.PUSH|default(0.3)|float}
    _BUZZ_DOOP
  {% endif %}

[gcode_macro DOCK_RESET]
description: Reset Docking
gcode:
  {% set svv = printer.save_variables.variables %}
  {% set existing_tool = svv.currently_docked_tool|default(0)|int %}
  {% if printer.limn.manual %}
    DOCK_CLEAR
  {% endif %}
  M118 [Dock][reset] Existing Tool:{existing_tool} cleared.
  SAVE_VARIABLE VARIABLE=currently_docked_tool VALUE=0
  SAVE_VARIABLE VARIABLE=tool_offset_x VALUE=0
  SAVE_VARIABLE VARIABLE=tool_offset_y VALUE=0
  SAVE_VARIABLE VARIABLE=tool_offset_z VALUE=0
  SAVE_VARIABLE VARIABLE=tool_name VALUE='""'
  TOOL_CHANGE_PHASE PHASE=idle
  _BUZZ_DOOP

[gcode_macro DOCK_RECALL]
gcode:
  {% set svv = printer.save_variables.variables %}
  {% set existing_tool = svv.currently_docked_tool|default(0)|int %}
  M118 [Dock][recall] Existing Tool:{existing_tool}.
  _BUZZ_DOOP

[gcode_macro UNDOCK]
description: Dock current tool back to its original position. eg. UNDOCK
gcode:
  {% set svv = printer.save_variables.variables %}
  {% set existing_tool = svv.currently_docked_tool|default(0)|int %}

  _NO_MANUAL_TOOL
  LAZY_HOME

  {% if existing_tool == 0 %}
    # Undock if holding a tool
    M118 Nothing to undock.
  {% else %}
    _DOCK_TOOL T={existing_tool} ACT=undock
  {% endif %}

[limn]
serial: /dev/serial/by-id/usb-MicroPython_Board_in_FS_mode_e6625887d3390f34-if00
baud: 115200
tool_holder_i2c_bus: 1
tool_holder_address: 0x20
tool_holder_pins: 15:41, 14:42, 13:45, 12:43, 11:44
tool_holder_tag_address: 0x24
# LIT, the head's load cell (ext/limn/lit.py). Nothing else may hold this port while Klipper runs
lit_serial: /dev/serial/by-id/usb-MicroPython_Board_in_FS_mode_e464cc7143561721-if00


# TOOL_TAG_READ/WRITE saved the tag's offsets and set the LEDs already; this is the buzz.
# A macro of its own: printer.limn.tag is read when the macro starts.
[gcode_macro _RFID_FEEDBACK]
gcode:
  {% set tag = printer.limn.tag %}
  {% if not tag.ok %}
    _BUZZ_RFID_ERR
    M118 Tag: {tag.error}
  {% else %}
    _BUZZ_711
  {% endif %}


[gcode_macro WRITE_TOOL_TAG]
gcode:
    {% set dx = ' DX=' ~ params.DX if 'DX' in params else '' %}
    {% set dy = ' DY=' ~ params.DY if 'DY' in params else '' %}
    {% set dz = ' DZ=' ~ params.DZ if 'DZ' in params else '' %}
    {% set name = (" NAME='" ~ params.NAME ~ "'") if 'NAME' in params else '' %}
    {% set reference = ' REFERENCE=' ~ params.REFERENCE if 'REFERENCE' in params else '' %}
    TOOL_TAG_WRITE{dx}{dy}{dz}{name}{reference}
    _BUZZ_RFID_OK
    G1 Z7
    _RFID_FEEDBACK

[gcode_macro _RFID_HOME]
description: Move to the tag reader
gcode:
  _CLEAR_OFFSETS
  LAZY_HOME
  G1 F6500
  G1 X100
  G1 Y3
  G1 X135
  G1 Z7
  M400

# The reader doesn't always extend all the way: going into the carried tool's
# holder pushes it out. TOOL_TAG_READ/WRITE run this between tries
# (tool_holder_tag_retries in [limn]), with T= the carried tool when its holder
# reads empty, else T=0: then it only comes at the reader again (_RFID_HOME, the
# way a read after a write used to go). Never past X135 at the reader: holding
# a tool, there is only 1-2 cm along X before it hits the dock.
[gcode_macro _RFID_NUDGE]
description: Get the tag reader to extend fully, then back to it
gcode:
  {% set tool = params.T|default(0)|int %}
  {% if tool %}
    _HOLDER_REENTER T={tool}
  {% endif %}
  _RFID_HOME

# Into the tool's (empty) holder and out, holding the tool locked: _DOCK_TOOL's
# moves without the unlock. All the way in, onto the holder's switch, for a
# reliable push on the reader; the extension takes that switch as its own move.
# `gap` stops that many mm short instead.
[gcode_macro _HOLDER_REENTER]
description: Go into a tool's holder and out again, keeping the tool
variable_gap: 0
gcode:
  {% set tool_id = params.T|int %}
  {% set prefix = "tool_" ~ tool_id ~ "_" %}
  {% set dh = printer["gcode_macro _DOCK_HOME"] %}
  {% set dx = dh[prefix + "dx"] %}
  G90
  G1 Z9.2
  G1 F5500
  G1 X{dh[prefix + "x"]} Y{dh[prefix + "y"]}
  G1 Z{dh[prefix + "z"]}
  G91
  G1 Z{dh[prefix + "dz"]}
  G1 Y{dh[prefix + "dy"]}
  G1 X{dx / 2}
  G1 F2500
  G1 X{dx / 2 - gap}
  G1 F2000
  G1 X-{dx - gap}
  G1 Y-{dh[prefix + "dy"]}
  G1 Z-{dh[prefix + "dz"]}
  G1 F4500
  G90
  M400

[gcode_macro RFID_READ]
gcode:
  # Moves to the reader, reads, saves the offsets
  TOOL_TAG_READ
  _BUZZ_ACT
  G1 Z7
  _RFID_FEEDBACK
  # _APPLY_OFFSETS

# Read the tag of each tool in its holder, and of the carried one: TOOL_SCAN [T=41,43].
# Only occupied holders; ends with the tools home and TOOL_TAGS. The web UI takes the
# pens from what this reads (printer.limn.tools).
[gcode_macro TOOL_SCAN]
description: Read the tags of the tools: TOOL_SCAN [T=41,43]
gcode:
  {% set only = (params.T|default('')|string).replace(' ', '').split(',') | reject('equalto', '') | list %}
  {% set occupied = printer.limn.tool_holder.occupied or [] %}
  {% set carried = printer.save_variables.variables.currently_docked_tool|default(0)|int %}
  _NO_MANUAL_TOOL
  LAZY_HOME
  {% if carried and (not only or (carried|string) in only) %}
    RFID_READ
  {% endif %}
  {% for t in occupied %}
    {% if not only or (t|string) in only %}
      DOCK T={t} HOME=0
    {% endif %}
  {% endfor %}
  UNDOCK
  _HOME_IF_UNHOMED_DOCKS
  TOOL_TAGS

# After pickups without homing (DOCK HOME=0): home now. Its own macro: it looks at the
# count when it runs, not when the macro calling it started.
[gcode_macro _HOME_IF_UNHOMED_DOCKS]
gcode:
  {% if printer["gcode_macro _DOCK_HOME"].docks_unhomed|int > 0 %}
    G28
  {% endif %}

[gcode_macro DOCK_SCAN]
description: TOOL_SCAN, its old name
gcode:
  TOOL_SCAN {rawparams}

# Give a tool its pen and colour (and name) on its tag, the offsets stay:
# TOOL_TAG_SET T=43 PEN=mic-01 COLOR=1f4aa8 NAME="Micron 01 Blue" [REFERENCE=0|1].
# COLOR without the # (it starts a comment); PEN= is a key of plot/profiles/pens.toml.
[gcode_macro TOOL_TAG_SET]
description: Write a tool's pen, colour, name: TOOL_TAG_SET T=43 [PEN=] [COLOR=rrggbb] [NAME=] [REFERENCE=0|1]
gcode:
  {% set t = params.T|int %}
  {% set pen = (' PEN=' ~ params.PEN) if 'PEN' in params else '' %}
  {% set color = (' COLOR=' ~ params.COLOR) if 'COLOR' in params else '' %}
  {% set name = (' NAME="' ~ params.NAME ~ '"') if 'NAME' in params else '' %}
  {% set reference = (' REFERENCE=' ~ params.REFERENCE) if 'REFERENCE' in params else '' %}
  {% if not (pen or color or name or reference) %}
    { action_raise_error("TOOL_TAG_SET: give PEN=, COLOR=, NAME= or REFERENCE=") }
  {% endif %}
  {% if params.PEN|default('')|length > 8 or params.NAME|default('')|length > 20 %}
    { action_raise_error("TOOL_TAG_SET: PEN= up to 8 characters, NAME= up to 20") }
  {% endif %}
  LAZY_HOME
  DOCK T={t} HOME=0
  TOOL_TAG_WRITE{pen}{color}{name}{reference}
  UNDOCK
  _HOME_IF_UNHOMED_DOCKS

[gcode_macro PLOT_START]
gcode:
  _BUZZ_711
  {% set tool = params.EXT|default(0)|int %}

# A poster's next sheet (plot/poster.py): PLOT_END has put the pen away. Waits, paused, for the
# sheet to be taken off and a new one put on; RESUME goes on with it.
[gcode_macro SHEET_NEXT]
description: A poster's next sheet: pause until a new sheet is on the bed (then RESUME). SHEET_NEXT N=2 OF=6
gcode:
  {% set n = params.N|default(0)|int %}
  {% set of = params.OF|default(0)|int %}
  M118 Sheet {n} of {of}: take the plotted sheet off, put a new one on the bed, then RESUME
  _BUZZ_DOOP
  PAUSE

[gcode_macro PLOT_END]
gcode:
  {% if not printer.limn.manual %}
    UNDOCK
  {% endif %}
  _BUZZ_711

[gcode_macro LIMN_SENSOR_CALIBRATE]
gcode:
  {% set press = (' PRESS=' ~ params.PRESS) if 'PRESS' in params else '' %}
  LRT_CALIBRATE{press}

[gcode_macro LIMN_TOOL_CALIBRATE]
gcode:
  {% set svv = printer.save_variables.variables %}
  {% set existing_tool = svv.currently_docked_tool|default(0)|int %}
  {% set dock_tool = params.T|default(0)|int %}

  {% if existing_tool == 0 and dock_tool <= 40%}
    M118 Not holding a tool and none specified.
  {% else %}
    {% if dock_tool > 40 %}
      DOCK T={dock_tool}
    {% else %}
      G28
    {% endif %}

    {% set press = (' PRESS=' ~ params.PRESS) if 'PRESS' in params else '' %}
    LRT_PROBE_TOOL{press}
  {% endif %}

[gcode_macro LIMN_CALIBRATE_ALL]
gcode:
  LIMN_TOOL_CALIBRATE T=41
  LIMN_TOOL_CALIBRATE T=42
  LIMN_TOOL_CALIBRATE T=43
  LIMN_TOOL_CALIBRATE T=44
  LIMN_TOOL_CALIBRATE T=45



# Support Toolchange commands. Fluidd shows T0..T4 as buttons: the limn extension
# sets their `color` (the holder's state) and `active` (the carried tool).
[gcode_macro T42]
gcode:
  UNDOCK

[gcode_macro T0]
description: Tool 41. The dot: its holder (green home, none empty, red failed)
variable_color: ''
variable_active: False
gcode:
  DOCK T=41
[gcode_macro T1]
description: Tool 42. The dot: its holder (green home, none empty, red failed)
variable_color: ''
variable_active: False
gcode:
  DOCK T=42
[gcode_macro T2]
description: Tool 43. The dot: its holder (green home, none empty, red failed)
variable_color: ''
variable_active: False
gcode:
  DOCK T=43
[gcode_macro T3]
description: Tool 44. The dot: its holder (green home, none empty, red failed)
variable_color: ''
variable_active: False
gcode:
  DOCK T=44
[gcode_macro T4]
description: Tool 45. The dot: its holder (green home, none empty, red failed)
variable_color: ''
variable_active: False
gcode:
  DOCK T=45

# Support manual tool changes
[gcode_macro T5]
gcode:
  DOCK T=41
[gcode_macro T6]
gcode:
  DOCK T=42
[gcode_macro T7]
gcode:
  DOCK T=43
[gcode_macro T8]
gcode:
  DOCK T=44
[gcode_macro T9]
gcode:
  DOCK T=45
