prashnts/limn/klipper/leds.cfg

[neopixel indockator]
pin: rpi:gpio17
chain_count: 30
color_order: GRB

[neopixel lamp]
pin: rpi:gpio16
chain_count: 30
color_order: GRBW

[neopixel picam]
pin: rpi:gpio15
chain_count: 32
color_order: GRB

[led_effect lamp_idle]
autostart:              true
frame_rate: 8
leds:
    neopixel:lamp
layers:
    static     1 0 lighten (0,0,0,.2)



[led_effect ui_xstepper_trigger]
leds:
    neopixel:picam (3)
autostart: true
endstops: stepper_x
layers:
    homing     15 0 add (0.7,0,0)

[led_effect ui_ystepper_trigger]
leds:
    neopixel:picam (11)
autostart: true
endstops: stepper_y
layers:
    homing     15 0 add (0,0.7,0)

[led_effect ui_zstepper_trigger]
leds:
    neopixel:picam (19)
autostart: true
endstops: stepper_z
layers:
    homing     15 0 add (0,0.2,0.9)

[led_effect ui_xyzstepper_trigger]
leds:
    neopixel:picam (3,11,19)
autostart: false
endstops: stepper_x,stepper_y,stepper_z
layers:
    homing     15 0 add (0.22,0.53,0)


[led_effect cam_idle]
autostart:              false
frame_rate: 8
leds:
    neopixel:picam
layers:
    static 1 0 top (0.5,0.5,0.1)

# The calibration's "touch the panel now" prompt (ext/limn/rtp.py)
[led_effect ui_alert_blink]
autostart:              false
frame_rate: 8
leds:
    neopixel:picam (1,2,9,10)
layers:
    blink 2 0.5 top (0.55,0.37,0)

### Arrows
[led_effect ui_arrow_top_right]
autostart:              false
frame_rate: 8
leds:
    neopixel:picam (5,6,7,8,15,16,22,24,29,32)
layers:
    blink 2 0.5 top (0.55,0.37,0)

[led_effect ui_arrow_bottom_left]
autostart:              false
frame_rate: 8
leds:
    neopixel:picam (2,12,20,28,21,14,7,29,30,31)
layers:
    blink 2 0.5 top (0.55,0.37,0)

[led_effect ui_arrow_down]
autostart:              false
frame_rate: 8
leds:
    neopixel:picam (12,21,30,23,16,22,14,6)
layers:
    blink 2 0.5 top (0.55,0.37,0)

[led_effect ui_arrow_down_btn]
autostart:              false
frame_rate: 8
leds:
    neopixel:picam (12,21,30,23,16,22,14,6)
layers:
    static 2 0.5 top (0.2,0.67,0.2)

[led_effect ui_arrow_up]
autostart:              false
frame_rate: 8
leds:
    neopixel:picam (20,13,6,15,24,14,22,30)
layers:
    blink 2 0.5 top (0.55,0.37,0)





[led_effect ui_key_locked]
autostart:              false
leds:
    neopixel:picam (27)
layers:
    static  1 1 top (0.4, 0, 0)

[led_effect ui_key_unlocked]
autostart:              false
leds:
    neopixel:picam (27)
layers:
    static  1 1 top (0, 0.4, 0)

### Tool holders and the UI
#
# The limn extension decides what these show and sets them with STATE=...
# (see ext/limn/leds.py); here is only how each state looks. Every style is
# one or more led_effect layer lines, picked by the effect's name prefix.
#
# UI strip (picam), a 4x8 matrix, 1 is top left:
#    1  2 |  3 |  4  5  6 |  7 |  8
#    9 10 | 11 | 12 13 14 | 15 | 16      1,2,9,10    alert
#   17 18 | 19 | 20 21 22 | 23 | 24      3,11,19     x/y/z endstops
#   25 26 | 27 | 28 29 30 | 31 | 32      17,18,25,26 tag
#                                        27          lock
#                                        cols 4-6    a tool's number (T0 is holder 41):
#                                                    the carried one, or one drying out
#                                        16,24,32    tool change: red approach,
#                                                    yellow engage, green leave/done
# Dock strip (indockator), status only, one segment per holder:
#   41: 1-4   42: 6-10   43: 13-17   44: 20-23   45: 26-30

[gcode_macro _led_styles]
description: The looks of the tool holder and UI states
# Dock strip: status only, steady. A state without a style here is dark:
# carried and missing (the holder is empty), unknown (holders unreadable).
variable_holder_occupied: 'static 1 0 top (0.0, 0.30, 0.10)'
variable_holder_error:    'static 1 0 top (0.60, 0.0, 0.0)'
# A known pen out of its cap for too long (ext/limn/drying.py): amber, orange,
# red, blinking faster as it goes on
variable_holder_drying_1: 'blink 1.2 0.5 top (0.55, 0.30, 0.0)'
variable_holder_drying_2: 'blink 0.8 0.5 top (0.75, 0.15, 0.0)'
variable_holder_drying_3: 'blink 0.4 0.5 top (0.90, 0.0, 0.0)'
# The carried tool's digit
variable_digit_target:    'breathing 1.2 0 top (0.20, 0.30, 0.90)'
variable_digit_untagged:  'static 1 0 top (0.45, 0.25, 0.0)'
variable_digit_carried:   'static 1 0 top (0.40, 0.40, 0.40)'
variable_digit_drying_1:  'blink 1.2 0.5 top (0.55, 0.30, 0.0)'
variable_digit_drying_2:  'blink 0.8 0.5 top (0.75, 0.15, 0.0)'
variable_digit_drying_3:  'blink 0.4 0.5 top (0.90, 0.0, 0.0)'
# Tool change phase
variable_red_on:          'static 1 0 top (0.9, 0.0, 0.0)'
variable_red_blink:       'blink 0.6 0.5 top (0.9, 0.0, 0.0)'
variable_yellow_on:       'static 1 0 top (0.45, 0.40, 0.0)'
variable_green_on:        'static 1 0 top (0.05, 0.9, 0.0)'
variable_green_blink:     'blink 0.6 0.5 top (0.05, 0.9, 0.0)'
# Tag
variable_tag_reading:     'blink 0.8 0.3 top (0.30, 0.40, 0.50)'
variable_tag_ok:          'static 1 0 top (0.0, 0.80, 0.10)'
variable_tag_error:       'blink 0.5 0.6 top (0.80, 0.10, 0.20)'
# A tag held to the reader by hand: listening (after a hand on the holders),
# scanned (put it into a holder now), taken (a holder took it), late (none did)
variable_tag_listening:   'breathing 2 0 top (0.0, 0.12, 0.15)'
variable_tag_scanned:     'blink 0.3 0.5 top (0.0, 0.60, 0.70)'
variable_tag_taken:       'static 1 0 top (0.0, 0.80, 0.10)'
variable_tag_late:        'blink 0.5 0.6 top (0.80, 0.10, 0.20)'
# Alert: the machine's mood, most urgent first (see ext/limn/leds.py). Green
# is fine, blue busy, amber look here, red stop; faster is fresher/more urgent.
# The spinners are a 4 colour `pattern` going round the 2x2, clockwise; their
# rate should be a whole number of frames at 20 fps (0.1, 0.2, 0.25, 0.4 ..).
variable_alert_error_new:       'blink 0.25 0.5 top (1.0, 0.0, 0.0)'
variable_alert_error:           'blink 0.8 0.5 top (0.9, 0.0, 0.0)'
# A pen drying out: red and amber going round the 2x2, faster as it goes on
variable_alert_drying_1:        'pattern 0.4 1 top (0.45,0.25,0),(0.10,0.04,0),(0.45,0.25,0),(0.10,0.04,0)'
variable_alert_drying_2:        'pattern 0.25 1 top (0.8,0.2,0),(0.15,0.02,0),(0.5,0.3,0),(0.15,0.02,0)'
variable_alert_drying_3:        'pattern 0.1 1 top (1.0,0,0),(0.2,0,0),(0.6,0.35,0),(0.2,0,0)'
variable_alert_busy_approach:   'pattern 0.25 1 top (0,0,0),(0.02,0.04,0.12),(0.08,0.14,0.40),(0.25,0.40,1.0)'
variable_alert_busy_engage:     'pattern 0.1 1 top (0,0,0),(0.02,0.04,0.12),(0.08,0.14,0.40),(0.25,0.40,1.0)'
variable_alert_busy_leave:      'pattern 0.2 1 top (0,0,0),(0.02,0.04,0.12),(0.08,0.14,0.40),(0.25,0.40,1.0)'
variable_alert_reading:         'pattern 0.1 1 top (0,0,0),(0.0,0.06,0.06),(0.0,0.20,0.20),(0.0,0.60,0.60)'
variable_alert_success:         'blink 0.3 0.5 top (0.05, 0.90, 0.10)'
variable_alert_attention_fast:  'blink 0.3 0.5 top (0.65, 0.42, 0.0)'
variable_alert_attention:       'blink 0.6 0.5 top (0.55, 0.37, 0.0)'
variable_alert_attention_slow:  'blink 1.2 0.4 top (0.45, 0.30, 0.0)'
variable_alert_warn:            'breathing 3 0 top (0.50, 0.25, 0.0)'
variable_alert_waiting:         'breathing 2 0 top (0.55, 0.32, 0.0)'
variable_alert_working:         'pattern 0.4 1 top (0,0,0),(0.02,0.04,0.12),(0.08,0.14,0.40),(0.20,0.32,0.80)'
variable_alert_plotting:        'breathing 6 0 top (0.04, 0.08, 0.25)'
variable_alert_ready:           'breathing 3 0 top (0.0, 0.35, 0.08)'
variable_alert_ok:              'breathing 6 0 top (0.0, 0.10, 0.03)'
# The stage's icons (ui_icon, columns 4-8): [shape, tint, breathing period in s (0: still)].
# A shape is 4 rows of 5, top first, each pixel . (off) or 1-9 (ninths of the tint): arrows
# and chevrons, sharp like the ui_arrow_* ones. Blue is
# the machine at work (with the tool's digit by turns), amber asks you for something (it
# breathes while it waits on you), green says done, amber to red a pen drying out.
variable_shape_calibrate: '9...9|.9.9.|.9.9.|9...9'
variable_shape_probe:     '..9..|9.9.9|.999.|44944'
variable_shape_mesh:      '9...9|.9.9.|..9..|35753'
variable_shape_mark:      '..9..|...9.|99999|...9.'
variable_shape_wipe:      '.9.9.|99999|.9.9.|55555'
variable_shape_paper:     '..9..|.999.|9.9.9|99999'
variable_shape_drop:      '..9..|.999.|99999|..9..'
variable_tint_busy:       [0.12, 0.22, 0.60]
variable_tint_ask:        [0.50, 0.30, 0.0]
variable_tint_done:       [0.05, 0.50, 0.12]
variable_tint_dry_1:      [0.55, 0.30, 0.0]
variable_tint_dry_2:      [0.75, 0.15, 0.0]
variable_tint_dry_3:      [0.90, 0.0, 0.0]
variable_icon_calibrate:  ['calibrate', 'busy', 0]
variable_icon_probe:      ['probe', 'busy', 0]
variable_icon_mesh:       ['mesh', 'busy', 0]
variable_icon_mark:       ['mark', 'busy', 0]
variable_icon_wipe:       ['wipe', 'ask', 3]
variable_icon_wiped:      ['wipe', 'done', 0]
variable_icon_paper:      ['paper', 'ask', 0]
variable_icon_drying_1:   ['drop', 'dry_1', 3]
variable_icon_drying_2:   ['drop', 'dry_2', 2]
variable_icon_drying_3:   ['drop', 'dry_3', 1]
# A plot's progress up column 7 (ui_progress): each LED half, then full; the rest a faint track
variable_progress_tint:   [0.10, 0.16, 0.40]
gcode:
  M118 Tool holder LED states are set by the limn extension, see TOOL_LEDS.

[led_effect holder_41]
leds:
    neopixel:indockator (1-4)
recalculate: true
frame_rate: 12
layers:
    {printer["gcode_macro _led_styles"]["holder_" ~ params.STATE|default('off')|lower]|default('')}

[led_effect holder_42]
leds:
    neopixel:indockator (6-10)
recalculate: true
frame_rate: 12
layers:
    {printer["gcode_macro _led_styles"]["holder_" ~ params.STATE|default('off')|lower]|default('')}

[led_effect holder_43]
leds:
    neopixel:indockator (13-17)
recalculate: true
frame_rate: 12
layers:
    {printer["gcode_macro _led_styles"]["holder_" ~ params.STATE|default('off')|lower]|default('')}

[led_effect holder_44]
leds:
    neopixel:indockator (20-23)
recalculate: true
frame_rate: 12
layers:
    {printer["gcode_macro _led_styles"]["holder_" ~ params.STATE|default('off')|lower]|default('')}

[led_effect holder_45]
leds:
    neopixel:indockator (26-30)
recalculate: true
frame_rate: 12
layers:
    {printer["gcode_macro _led_styles"]["holder_" ~ params.STATE|default('off')|lower]|default('')}

# holder 41: T0, drawn as "0"
[led_effect ui_tool_41]
leds:
    neopixel:picam (4,5,6,12,14,20,22,28,29,30)
recalculate: true
frame_rate: 12
layers:
    {printer["gcode_macro _led_styles"]["digit_" ~ params.STATE|default('off')|lower]|default('')}

# holder 42: T1, drawn as "1"
[led_effect ui_tool_42]
leds:
    neopixel:picam (5,12,13,21,28,29,30)
recalculate: true
frame_rate: 12
layers:
    {printer["gcode_macro _led_styles"]["digit_" ~ params.STATE|default('off')|lower]|default('')}

# holder 43: T2, drawn as "2"
[led_effect ui_tool_43]
leds:
    neopixel:picam (4,5,14,21,28,29,30)
recalculate: true
frame_rate: 12
layers:
    {printer["gcode_macro _led_styles"]["digit_" ~ params.STATE|default('off')|lower]|default('')}

# holder 44: T3, drawn as "3"
[led_effect ui_tool_44]
leds:
    neopixel:picam (4,5,6,13,14,22,28,29,30)
recalculate: true
frame_rate: 12
layers:
    {printer["gcode_macro _led_styles"]["digit_" ~ params.STATE|default('off')|lower]|default('')}

# holder 45: T4, drawn as "4"
[led_effect ui_tool_45]
leds:
    neopixel:picam (4,6,12,14,20,21,22,30)
recalculate: true
frame_rate: 12
layers:
    {printer["gcode_macro _led_styles"]["digit_" ~ params.STATE|default('off')|lower]|default('')}

[led_effect ui_traffic_red]
leds:
    neopixel:picam (16)
recalculate: true
frame_rate: 12
layers:
    {printer["gcode_macro _led_styles"]["red_" ~ params.STATE|default('off')|lower]|default('')}

[led_effect ui_traffic_yellow]
leds:
    neopixel:picam (24)
recalculate: true
frame_rate: 12
layers:
    {printer["gcode_macro _led_styles"]["yellow_" ~ params.STATE|default('off')|lower]|default('')}

[led_effect ui_traffic_green]
leds:
    neopixel:picam (32)
recalculate: true
frame_rate: 12
layers:
    {printer["gcode_macro _led_styles"]["green_" ~ params.STATE|default('off')|lower]|default('')}

[led_effect ui_tag]
leds:
    neopixel:picam (17,18,25,26)
recalculate: true
frame_rate: 12
layers:
    {printer["gcode_macro _led_styles"]["tag_" ~ params.STATE|default('off')|lower]|default('')}

# The stage, columns 4-8 row by row: an icon (_led_styles icon_*), drawn as a `pattern` with
# one colour per LED; breathing icons multiply it by max(0.5, a breath): it never goes dark.
# The extension shows it or a digit, never both, and cross-fades between them (FADETIME).
[led_effect ui_icon]
leds:
    neopixel:picam (4-8,12-16,20-24,28-32)
recalculate: true
frame_rate: 12
layers:
    {% set s = printer["gcode_macro _led_styles"] %}{% set i = s["icon_" ~ params.STATE|default('off')|lower]|default(None) %}{% if i %}{% set c = s["tint_" ~ i[1]] %}pattern 0 0 {'multiply' if i[2] else 'top'} {% for ch in s["shape_" ~ i[0]] if ch != '|' %}{% set v = (0 if ch == '.' else ch|int) / 9 %}({(c[0] * v)|round(3)},{(c[1] * v)|round(3)},{(c[2] * v)|round(3)}){',' if not loop.last else ''}{% endfor %}{% endif %}
    {% if i and i[2] %}static 0 0 lighten (0.5,0.5,0.5){% endif %}
    {% if i and i[2] %}breathing {i[2]} 0 top (1,1,1){% endif %}

# A plot's progress, column 7 bottom up: STATE=p0..p8 (eighths)
[led_effect ui_progress]
leds:
    neopixel:picam (31,23,15,7)
recalculate: true
frame_rate: 4
layers:
    {% set n = (params.STATE|default('p0'))[1:]|int %}{% set c = printer["gcode_macro _led_styles"].progress_tint %}pattern 0 0 top {% for k in range(4) %}{% set v = 1.0 if n >= 2 * k + 2 else (0.4 if n == 2 * k + 1 else 0.08) %}({(c[0] * v)|round(3)},{(c[1] * v)|round(3)},{(c[2] * v)|round(3)}){',' if not loop.last else ''}{% endfor %}

# X, Y, Z: where the head is, a faint glow; X and Y brighter further out, Z brighter the
# lower it is (the pen near the paper). led_effect polls the steppers twice a second.
[led_effect ui_x_position]
leds:
    neopixel:picam (3)
autostart: true
frame_rate: 4
stepper: x
layers:
    steppercolor 1 0 top (0.0,0.01,0.03),(0.03,0.07,0.18)

[led_effect ui_y_position]
leds:
    neopixel:picam (11)
autostart: true
frame_rate: 4
stepper: y
layers:
    steppercolor 1 0 top (0.03,0.01,0.0),(0.18,0.07,0.0)

# Z -3..10: 0.0 at -3, 0.25 at 0.25, 0.5 at 3.5, 0.75 at 6.75: lit to about Z3.5 (raw)
[led_effect ui_z_position]
leds:
    neopixel:picam (19)
autostart: true
frame_rate: 4
stepper: z
layers:
    steppercolor 1 0 top (0.12,0.20,0.50),(0.07,0.12,0.30),(0.0,0.0,0.0),(0.0,0.0,0.0),(0.0,0.0,0.0)

# 1, 2, 10, 9: clockwise round the 2x2, for the spinners
[led_effect ui_alert]
leds:
    neopixel:picam (1,2,10,9)
recalculate: true
frame_rate: 20
layers:
    {printer["gcode_macro _led_styles"]["alert_" ~ params.STATE|default('off')|lower]|default('')}


# Lights: a white background under the UI matrix (neopixel picam), added to what
# the UI shows (led_effect sums the effects on an LED), so the UI keeps running.
# At LEVEL 1 every LED is full white and the UI's colours wash out; lower keeps them.
[led_effect ui_light]
leds:
    neopixel:picam
autostart: false
recalculate: true
frame_rate: 4
layers:
    static 1 0 add ({params.LEVEL|default(1)|float},{params.LEVEL|default(1)|float},{params.LEVEL|default(1)|float})

[gcode_macro LIGHTS_ON]
description: White background on the UI matrix, the UI on top. LIGHTS_ON [LEVEL=0..1, 1: full]
gcode:
  {% set level = [[params.LEVEL|default(1.0)|float, 0.0]|max, 1.0]|min %}
  SET_LED_EFFECT EFFECT=ui_light LEVEL={level} FADETIME=0.3

[gcode_macro LIGHTS_OFF]
description: The background off: the UI matrix as before
gcode:
  SET_LED_EFFECT EFFECT=ui_light STOP=1 FADETIME=0.3
  _UI_LEDS_RESTORE

# The UI matrix's own effects back on, eg. after STOP_LED_EFFECTS or a REPLACE=1
# over them (the old LIGHTS_ON/OFF did both): the always-on ones, and the ones
# the extension sets (TOOL_LEDS redraws them).
[gcode_macro _UI_LEDS_RESTORE]
gcode:
  {% for e in ['ui_xstepper_trigger', 'ui_ystepper_trigger', 'ui_zstepper_trigger',
               'ui_x_position', 'ui_y_position', 'ui_z_position'] %}
    SET_LED_EFFECT EFFECT={e}
  {% endfor %}
  {% if 'limn' in printer %}
    TOOL_LEDS
  {% endif %}
