prashnts/limn/klipper/limn_macros.cfg

# Made by ext/limn/fluidd.py from the extension (ext/limn/__init__.py): do not edit, make it again.
# Its commands as macros, so Fluidd lists them with their parameters. Each one runs the command
# (renamed _LIMN_<NAME>) with what it was given.

[gcode_macro LRT_CONNECT]
description: Connect to the Dock
rename_existing: _LIMN_LRT_CONNECT
gcode:
  _LIMN_LRT_CONNECT {rawparams}

[gcode_macro LRT_DISCONNECT]
description: Disconnect from the Dock
rename_existing: _LIMN_LRT_DISCONNECT
gcode:
  _LIMN_LRT_DISCONNECT {rawparams}

[gcode_macro LRT_READ_BED_ID]
description: Read which bed is on the plotter
rename_existing: _LIMN_LRT_READ_BED_ID
gcode:
  _LIMN_LRT_READ_BED_ID {rawparams}

[gcode_macro LRT_MESH_CALIBRATE]
description: LRT_MESH_CALIBRATE [IF_STALE=1]: meshes of the bed on the plotter, the whole bed without one
rename_existing: _LIMN_LRT_MESH_CALIBRATE
gcode:
  # what Fluidd shows as its parameters (the command reads them)
  {% set _ = params.CLEAN|default(1) %}
  {% set _ = params.DEBUG|default(0) %}
  {% set _ = params.DZ_TRIM|default('') %}
  {% set _ = params.IF_STALE|default(0) %}
  {% set _ = params.PRESS|default('') %}
  {% set _ = params.SURVEY|default(1) %}
  {% set _ = params.VERBOSE|default(0) %}
  _LIMN_LRT_MESH_CALIBRATE {rawparams}

[gcode_macro LRT_MARKS]
description: LRT_MARKS [RESET=1]: how full the sheet is (marks, purges), RESET: a new sheet
rename_existing: _LIMN_LRT_MARKS
gcode:
  # what Fluidd shows as its parameters (the command reads them)
  {% set _ = params.RESET|default(0) %}
  _LIMN_LRT_MARKS {rawparams}

[gcode_macro LRT_MARK]
description: LRT_MARK [TRIM=] [Z=]: the carried pen draws the next test mark now. TRIM: the dz trim to try (mm past first touch, as DZ_TRIM; the tags have the calibration's, 0.3), Z: the pen-down G-code Z itself (1.0 as a plot; lower is deeper). Neither: as a calibration draws it
rename_existing: _LIMN_LRT_MARK
gcode:
  # what Fluidd shows as its parameters (the command reads them)
  {% set _ = params.TRIM|default('') %}
  {% set _ = params.Z|default('') %}
  _LIMN_LRT_MARK {rawparams}

[gcode_macro LRT_WIPE]
description: LRT_WIPE [RESET=1]: the wipe area's next slot, RESET: a fresh pad
rename_existing: _LIMN_LRT_WIPE
gcode:
  # what Fluidd shows as its parameters (the command reads them)
  {% set _ = params.RESET|default(0) %}
  _LIMN_LRT_WIPE {rawparams}

[gcode_macro LRT_CALIBRATE]
description: LRT_CALIBRATE [PRESS=] [DZ_TRIM=] [MESH=1]: calibrate the bed with the reference tool (T4); PRESS: mm the FSR taps press at most; DZ_TRIM: mm the pens press past first touch at Z1, more is deeper (FSR, beds.py dz_trim; kept with the calibration, the pens take it); MESH=1: new meshes even when they are of the bed as it sits
rename_existing: _LIMN_LRT_CALIBRATE
gcode:
  # what Fluidd shows as its parameters (the command reads them)
  {% set _ = params.CLEAN|default(1) %}
  {% set _ = params.DEBUG|default(0) %}
  {% set _ = params.DZ_TRIM|default('') %}
  {% set _ = params.MESH|default(0) %}
  {% set _ = params.PRESS|default('') %}
  {% set _ = params.SURVEY|default(1) %}
  {% set _ = params.VERBOSE|default(0) %}
  _LIMN_LRT_CALIBRATE {rawparams}

[gcode_macro LRT_PROBE_TOOL]
description: LRT_PROBE_TOOL [PRESS=] [DZ_TRIM=]: measure the docked tool's offsets and write its tag; DZ_TRIM: this pen's own trim (default: the one the reference was calibrated with)
rename_existing: _LIMN_LRT_PROBE_TOOL
gcode:
  # what Fluidd shows as its parameters (the command reads them)
  {% set _ = params.CLEAN|default(1) %}
  {% set _ = params.DEBUG|default(0) %}
  {% set _ = params.DZ_TRIM|default('') %}
  {% set _ = params.MESH|default(0) %}
  {% set _ = params.PRESS|default('') %}
  {% set _ = params.SURVEY|default(1) %}
  {% set _ = params.VERBOSE|default(0) %}
  _LIMN_LRT_PROBE_TOOL {rawparams}

[gcode_macro LRT_FSR_Z]
description: Jog the tool onto an FSR cell, report the contact z
rename_existing: _LIMN_LRT_FSR_Z
gcode:
  # what Fluidd shows as its parameters (the command reads them)
  {% set _ = params.CELL|default('') %}
  {% set _ = params.CLEAN|default(1) %}
  {% set _ = params.DEBUG|default(0) %}
  {% set _ = params.DZ_TRIM|default('') %}
  {% set _ = params.PRESS|default('') %}
  {% set _ = params.SURVEY|default(1) %}
  {% set _ = params.VERBOSE|default(0) %}
  _LIMN_LRT_FSR_Z {rawparams}

[gcode_macro LRT_FSR_EDGE]
description: Find an FSR cell edge with the tool
rename_existing: _LIMN_LRT_FSR_EDGE
gcode:
  # what Fluidd shows as its parameters (the command reads them)
  {% set _ = params.AXIS|default('X') %}
  {% set _ = params.CLEAN|default(1) %}
  {% set _ = params.DEBUG|default(0) %}
  {% set _ = params.DZ_TRIM|default('') %}
  {% set _ = params.INDEX|default(0) %}
  {% set _ = params.PRESS|default('') %}
  {% set _ = params.SURVEY|default(1) %}
  {% set _ = params.VERBOSE|default(0) %}
  _LIMN_LRT_FSR_EDGE {rawparams}

[gcode_macro LRT_FSR_MEASURE]
description: LRT_FSR_MEASURE [BED_Z=] [TIP=x,y] [Z=] [PRESS=]: measure the carried tool on the FSR like LRT_PROBE_TOOL, only report it
rename_existing: _LIMN_LRT_FSR_MEASURE
gcode:
  # what Fluidd shows as its parameters (the command reads them)
  {% set _ = params.BED_Z|default('') %}
  {% set _ = params.CLEAN|default(1) %}
  {% set _ = params.DEBUG|default(0) %}
  {% set _ = params.DZ_TRIM|default('') %}
  {% set _ = params.PRESS|default('') %}
  {% set _ = params.SURVEY|default(1) %}
  {% set _ = params.TIP|default('') %}
  {% set _ = params.VERBOSE|default(0) %}
  {% set _ = params.Z|default('') %}
  _LIMN_LRT_FSR_MEASURE {rawparams}

[gcode_macro LRT_FSR_MAP]
description: LRT_FSR_MAP [STEP=1.25] [MARGIN=1] [RISE=40] [DEPTH=0.02] [TIP=x,y] [REFINE=1]: touch the FSR spot by spot, which cell answers where: its layout, origin (refined by edge searches) and pitch, a picture in the logs (fsr-maps/)
rename_existing: _LIMN_LRT_FSR_MAP
gcode:
  # what Fluidd shows as its parameters (the command reads them)
  {% set _ = params.CLEAN|default(1) %}
  {% set _ = params.DEBUG|default(0) %}
  {% set _ = params.DEPTH|default(0.02) %}
  {% set _ = params.DZ_TRIM|default('') %}
  {% set _ = params.MARGIN|default(1.0) %}
  {% set _ = params.PRESS|default('') %}
  {% set _ = params.REFINE|default(1) %}
  {% set _ = params.RISE|default(40.0) %}
  {% set _ = params.STEP|default(1.25) %}
  {% set _ = params.SURVEY|default(1) %}
  {% set _ = params.TIP|default('') %}
  {% set _ = params.VERBOSE|default(0) %}
  _LIMN_LRT_FSR_MAP {rawparams}

[gcode_macro LRT_FSR_SURVEY]
description: LRT_FSR_SURVEY [CLEAR=1]: press every cell of the FSR with the carried tool (a felt tip), find the faulty and weak ones, the noise, an aim; saved and used by every measurement after
rename_existing: _LIMN_LRT_FSR_SURVEY
gcode:
  # what Fluidd shows as its parameters (the command reads them)
  {% set _ = params.CLEAN|default(1) %}
  {% set _ = params.CLEAR|default(0) %}
  {% set _ = params.DEBUG|default(0) %}
  {% set _ = params.DZ_TRIM|default('') %}
  {% set _ = params.PRESS|default('') %}
  {% set _ = params.SURVEY|default(1) %}
  {% set _ = params.VERBOSE|default(0) %}
  _LIMN_LRT_FSR_SURVEY {rawparams}

[gcode_macro LRT_FSR_CLEAN]
description: LRT_FSR_CLEAN: park the carried tool and wait for the FSR sheet to be wiped (before the BLTouch probes it: ink holds the probe up)
rename_existing: _LIMN_LRT_FSR_CLEAN
gcode:
  # what Fluidd shows as its parameters (the command reads them)
  {% set _ = params.CLEAN|default(1) %}
  {% set _ = params.DEBUG|default(0) %}
  {% set _ = params.DZ_TRIM|default('') %}
  {% set _ = params.PRESS|default('') %}
  {% set _ = params.SURVEY|default(1) %}
  {% set _ = params.VERBOSE|default(0) %}
  _LIMN_LRT_FSR_CLEAN {rawparams}

[gcode_macro LRT_FSR_MATRIX]
description: LRT_FSR_MATRIX [SECONDS=1] [DEBUG=1]: the FSR arrays in matrix mode, what arrives per hop. Nothing moves
rename_existing: _LIMN_LRT_FSR_MATRIX
gcode:
  # what Fluidd shows as its parameters (the command reads them)
  {% set _ = params.CLEAN|default(1) %}
  {% set _ = params.DEBUG|default(0) %}
  {% set _ = params.DZ_TRIM|default('') %}
  {% set _ = params.PRESS|default('') %}
  {% set _ = params.SECONDS|default(1.0) %}
  {% set _ = params.SURVEY|default(1) %}
  {% set _ = params.VERBOSE|default(0) %}
  _LIMN_LRT_FSR_MATRIX {rawparams}

[gcode_macro LRT_CHAIN]
description: Show the MCUs on the chain and the link counters
rename_existing: _LIMN_LRT_CHAIN
gcode:
  _LIMN_LRT_CHAIN {rawparams}

[gcode_macro LRT_DEBUG]
description: LRT_DEBUG ON=0|1: show sensor data
rename_existing: _LIMN_LRT_DEBUG
gcode:
  # what Fluidd shows as its parameters (the command reads them)
  {% set _ = params.ON|default('') %}
  _LIMN_LRT_DEBUG {rawparams}

[gcode_macro LIT_STATUS]
description: LIT_STATUS: the head's load cell: force now, its flags
rename_existing: _LIMN_LIT_STATUS
gcode:
  _LIMN_LIT_STATUS {rawparams}

[gcode_macro LIT_TARE]
description: LIT_TARE: zero the head's load cell here (nothing touching)
rename_existing: _LIMN_LIT_TARE
gcode:
  _LIMN_LIT_TARE {rawparams}

[gcode_macro LIT_ARM]
description: LIT_ARM: tare, then arm the touch line (before a probe)
rename_existing: _LIMN_LIT_ARM
gcode:
  _LIMN_LIT_ARM {rawparams}

[gcode_macro LIT_THRESHOLD]
description: LIT_THRESHOLD G=3 [RELEASE=]: grams that trigger the touch line, release (default 0.7 G)
rename_existing: _LIMN_LIT_THRESHOLD
gcode:
  # what Fluidd shows as its parameters (the command reads them)
  {% set _ = params.G|default(3.0) %}
  {% set _ = params.RELEASE|default('') %}
  _LIMN_LIT_THRESHOLD {rawparams}

[gcode_macro LIT_DEBUG]
description: LIT_DEBUG [ON=0|1] [EVERY=0.5]: a console line with the force every EVERY s
rename_existing: _LIMN_LIT_DEBUG
gcode:
  # what Fluidd shows as its parameters (the command reads them)
  {% set _ = params.EVERY|default(0.5) %}
  {% set _ = params.ON|default('') %}
  _LIMN_LIT_DEBUG {rawparams}

[gcode_macro LIT_LOG]
description: LIT_LOG [START=1|0] [NAME=]: every sample, with where the toolhead was, to logs/limn-cell/<NAME>.jsonl (100/s while it runs)
rename_existing: _LIMN_LIT_LOG
gcode:
  # what Fluidd shows as its parameters (the command reads them)
  {% set _ = params.NAME|default('') %}
  {% set _ = params.START|default('') %}
  _LIMN_LIT_LOG {rawparams}

[gcode_macro TOOL_HOLDERS]
description: Show which tool holders have their tool
rename_existing: _LIMN_TOOL_HOLDERS
gcode:
  _LIMN_TOOL_HOLDERS {rawparams}

[gcode_macro TOOL_HOLDER_CHECK]
description: TOOL_HOLDER_CHECK T=41 EXPECT=occupied|empty [ARM=1]: stop unless the holder is so
rename_existing: _LIMN_TOOL_HOLDER_CHECK
gcode:
  # what Fluidd shows as its parameters (the command reads them)
  {% set _ = params.ARM|default(0) %}
  {% set _ = params.EXPECT|default('') %}
  {% set _ = params.T|default('') %}
  _LIMN_TOOL_HOLDER_CHECK {rawparams}

[gcode_macro TOOL_TAG_READ]
description: Read the carried tool's tag [MOVE=0]
rename_existing: _LIMN_TOOL_TAG_READ
gcode:
  # what Fluidd shows as its parameters (the command reads them)
  {% set _ = params.MOVE|default(1) %}
  _LIMN_TOOL_TAG_READ {rawparams}

[gcode_macro TOOL_TAG_WRITE]
description: TOOL_TAG_WRITE [DX= DY= DZ= NAME= REFERENCE=0|1 PEN= COLOR=rrggbb] [MOVE=0]: write these to the carried tool's tag
rename_existing: _LIMN_TOOL_TAG_WRITE
gcode:
  # what Fluidd shows as its parameters (the command reads them)
  {% set _ = params.COLOR|default('') %}
  {% set _ = params.DX|default('') %}
  {% set _ = params.DY|default('') %}
  {% set _ = params.DZ|default('') %}
  {% set _ = params.MOVE|default(1) %}
  {% set _ = params.NAME|default('') %}
  {% set _ = params.PEN|default('') %}
  {% set _ = params.REFERENCE|default('') %}
  _LIMN_TOOL_TAG_WRITE {rawparams}

[gcode_macro TOOL_TAGS]
description: The last tag read of each holder's tool (TOOL_SCAN reads them all)
rename_existing: _LIMN_TOOL_TAGS
gcode:
  _LIMN_TOOL_TAGS {rawparams}

[gcode_macro TOOL_CHANGE_PHASE]
description: TOOL_CHANGE_PHASE PHASE=engage|leave|idle: the tool change's step, for the LEDs
rename_existing: _LIMN_TOOL_CHANGE_PHASE
gcode:
  # what Fluidd shows as its parameters (the command reads them)
  {% set _ = params.PHASE|default('') %}
  _LIMN_TOOL_CHANGE_PHASE {rawparams}

[gcode_macro TOOL_LEDS]
description: Redraw the tool holder and UI LEDs, show their states
rename_existing: _LIMN_TOOL_LEDS
gcode:
  _LIMN_TOOL_LEDS {rawparams}

[gcode_macro TOOL_DRY]
description: TOOL_DRY [RESET=1 [T=41]] [SILENCE=1]: how long each known pen has been out of its cap
rename_existing: _LIMN_TOOL_DRY
gcode:
  # what Fluidd shows as its parameters (the command reads them)
  {% set _ = params.RESET|default(0) %}
  {% set _ = params.SILENCE|default(0) %}
  {% set _ = params.T|default('') %}
  _LIMN_TOOL_DRY {rawparams}

[gcode_macro DOCK_MANUAL]
description: Dock a tool by hand: hold its tag to the reader, then push it onto the carriage
rename_existing: _LIMN_DOCK_MANUAL
gcode:
  _LIMN_DOCK_MANUAL {rawparams}

[gcode_macro DOCK_CLEAR]
description: The tool docked by hand is off the carriage: the dock is free again
rename_existing: _LIMN_DOCK_CLEAR
gcode:
  _LIMN_DOCK_CLEAR {rawparams}

[gcode_macro TOOL_SWAP]
description: TOOL_SWAP T=41 [PEN=] [COLOR=rrggbb] [NAME=] [CALIBRATE=1]: a pen by hand into a holder mid-plot: pauses until it is scanned and in, then resumes
rename_existing: _LIMN_TOOL_SWAP
gcode:
  # what Fluidd shows as its parameters (the command reads them)
  {% set _ = params.CALIBRATE|default(0) %}
  {% set _ = params.COLOR|default('') %}
  {% set _ = params.NAME|default('') %}
  {% set _ = params.PEN|default('') %}
  {% set _ = params.T|default('') %}
  _LIMN_TOOL_SWAP {rawparams}

[gcode_macro TOOL_PREPARE]
description: TOOL_PREPARE [CALIBRATE=auto|0|1] [PRIME=0|1]: the carried pen before it plots: probed when its tag has no offsets, primed in the wipe area
rename_existing: _LIMN_TOOL_PREPARE
gcode:
  # what Fluidd shows as its parameters (the command reads them)
  {% set _ = params.CALIBRATE|default('auto') %}
  {% set _ = params.CLEAN|default(1) %}
  {% set _ = params.DEBUG|default(0) %}
  {% set _ = params.DZ_TRIM|default('') %}
  {% set _ = params.PRESS|default('') %}
  {% set _ = params.PRIME|default(0) %}
  {% set _ = params.SURVEY|default(1) %}
  {% set _ = params.VERBOSE|default(0) %}
  _LIMN_TOOL_PREPARE {rawparams}

[gcode_macro TOOL_PRIME]
description: TOOL_PRIME: the carried pen draws a zigzag in the wipe area
rename_existing: _LIMN_TOOL_PRIME
gcode:
  _LIMN_TOOL_PRIME {rawparams}
