prashnts/limn/(commit log)

2026-04-24 Change to GPL V3
    This is to be in line with Klipper's license. Previous changes remain under MIT.
2026-05-12 feat: touch probe
    [buzzer.cfg, crownest.cfg, leds.cfg, limn.cfg, printer.cfg]
2026-05-25 add upy firmware for the bed + notes
2026-06-09 feat: full pen calibration with resistive panel
    [limn.cfg]
2026-06-10 feat: apply pen calibration and draw
    [buzzer.cfg, limn.cfg]
2026-06-11 feat: implement calibrated plotting
    [limn.cfg]
2026-06-13 update slicer conf
    [leds.cfg, limn.cfg]
2026-08-08 update leds conf
    [leds.cfg]
2026-08-13 feat: read tool state
    [leds.cfg]
2026-09-18 feat: bed detect
2026-09-19 feat: new bed
2026-09-23 fix: better fsr calibration
    [lrt_fsr_array.py]
2026-09-26 feat: update uart link
2026-09-26 feat: chain updates, mcu.py tool and touch trigger over DETECT
    - lib/ota.py + main.py bootloader: update files over the chain with
    sha256 checks, commit/confirm, rollback of unconfirmed or broken
    updates, rescue loop when the app does not start
    - node.json per MCU (nodes/): role, app, UARTs, pins, trigger
    - mcu.py: install over USB, topology, info, stats, send, monitor, update
    - lib/touch.py: bed nodes raise a touch line into DETECT when armed;
    RTP fires it from a pen-down hard IRQ
    - Dock: "detect" trigger with PIO timed 10ms pulse and arming, removal
    debounce, frame bridge for updates ("uart" trigger stays the default)
    - RTP: 1ms settle for X, Y and Z
    - ext/limn.py: arm(rtp) / disar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
    [lrt_dock_mcu.py, lrt_fsr_array.py, lrt_resistive_touch.py, main.py, mcu.py]
2026-09-26 fix: survive loop errors, report failed FSR calibration, settled RTP samples
    - link.Guard: main loops log an error up the chain and carry on; after
    20 in a row main.py falls back to the rescue loop
    - FSR: a calibration that times out is reported (state 13 + log) and
    keeps the previous baseline; dead knobs removed, same touch rule;
    diag() shows the sense pins' pull state, "fsr_pull_down" opt-in
    - RTP: touch samples whose reads are not settled (spread > max_spread)
    are not sent and are counted in the log; panel released between reads
    - Klipper: LRT_CHAIN shows hellos and link counters, MCU errors always shown
    - tests: error reporting, diag, calibration with the sheet pressed
    AI Assist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
    [lrt_dock_mcu.py, lrt_fsr_array.py, lrt_resistive_touch.py]
2026-09-26 fix: touch line off until the diodes are fitted, console command
    - nodes only arm when node.json has touch_pin; removed from the bed
    configs for now, so the RTP keeps measuring as before
    - mcu.py console: watch one board's output over USB, no Dock needed
    - tests: arming without touch_pin, old FSR firmware lines are dropped
    AI Assisted
    [mcu.py]
2026-09-26 feat: any MCU on USB can drive the chain below it
    - lib/bridge.py: the Dock's USB command/line handling, shared; bed nodes
    run it too, so without a Dock the first bed MCU is hop 0 for mcu.py
    (topology, monitor, update of the nodes below it)
    - link.tap: a USB host sees frames from below and the node's own
    - bridge.py added to the installed file set
    - tests: bench RTP -> FSR, FSR switched to fsr_bed3 through the RTP
    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
2026-09-26 feat: per-node data lines from the Dock, FSR matrix mode
    - Dock prints one `data` line per frame (hop, kind, state, values)
    instead of the merged SMP line, so two FSRs on one bed stay apart
    - Dock forwards every command it does not handle itself
    - FSR matrix(on)/matrix(off): all 32 cells every frame (state 43)
    - bridge: a read that returns nothing ends the command read
    - sim: UART writes never block, like a real UART
    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
2026-09-26 refactor: Klipper extension as a package, FSR tool alignment
    ext/limn.py -> ext/limn/, parts that work on their own:
    - dock.py: the Dock's serial in the reactor, lines by kind, request with
    a timeout (LRT_READ_BED_ID no longer waits forever)
    - samples.py, machine.py (the only Klipper contact), geometry.py (math),
    beds.py (what is on each bed, and where)
    - rtp.py: same RTP method (3-point fit + reference grid), same macros and
    order; retries bounded instead of looping forever
    - fsr.py: BED_5 with two arrays at right angles. Z by jogging onto a cell
    with a floor; XY by tapping both sides of the dead zone between two
    cells. Stops and lifts to park on a dead sensor, no contact, pressin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
    [beds.py, dock.py, fsr.py, geometry.py, machine.py, rtp.py, samples.py]
2026-09-27 feat: move i2c devs to limn ext
    [limn.cfg]
2026-09-27 fix: conf
    [limn.cfg]
2026-09-27 feat: tool holder and UI LEDs driven by the limn extension
    The extension now decides what the dock strip and the UI strip show
    (ext/limn/leds.py) and sets the led_effects directly, so the LEDs follow
    the holder switches and the tool change steps as they happen.
    klipper/leds.cfg only has the looks, in _led_styles.
    - Dock strip: per holder occupied, carried, missing, changing, hand
    change, failed check, unreadable.
    - UI strip: the carried tool's digit (same pixel art), the tool change
    phase on the traffic light, tag and alert states.
    - Macros report TOOL_CHANGE_PHASE instead of setting LEDs by hand.
    - TOOL_LEDS redraws and lists the states.
    - ui_info_processing no longer REPLACEs the tool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
    [leds.cfg, limn.cfg]
2026-09-27 feat: improved led ui
    [leds.cfg]
2026-09-27 feat: dock state on Fluidd's tool buttons
    T0..T4 get `color` (the holder's state, the dock strip's colours) and
    `active` (the carried tool), which Fluidd shows on its tool buttons. The
    extension sets them with the LEDs, only when they change. The macros are
    mapped by tool_holder_macros in [limn].
    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
    [limn.cfg]
2026-09-27 feat: retry tag reads by nudging the reader through the holder
    The reader doesn't always extend fully. TOOL_TAG_READ/WRITE now try again
    (tool_holder_tag_retries, default 2) after running _RFID_NUDGE between
    tries:
    - carrying a tool whose holder reads empty: _HOLDER_REENTER goes all the
    way into that holder and out, keeping the tool locked, which pushes the
    reader out; the holder switch firing meanwhile is taken as our own move
    - otherwise: _RFID_HOME again, the old read-after-write path
    Never past X135 at the reader. The tries go into printer.limn.tag.tries.
    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
    [limn.cfg]
2026-09-27 fix: disco leds
    [leds.cfg, limn.cfg]
2026-09-27 feat: calm LED strips: status-only dock strip, no comet waves
    Dock strip (indockator): steady holder status only. Green: tool home,
    off: holder empty or unreadable, red: a check failed there. The boot
    sweep and the critical_error strobe are gone, as are the holder
    animations (tool change, hand change, empty). Fluidd's tool buttons
    match: green home, no dot empty, red failed.
    UI strip: no more comet waves, ui_tool_sweep no longer covers the digits
    and ui_info_processing is removed with its uses.
    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
    [leds.cfg, limn.cfg]
2026-09-27 feat: improve test mark routine
    [limn.cfg]
2026-09-27 feat: reference tool tag flag, rebase the calibration after a bed move
    Tags get a REFERENCE flag (page 9, "LREF"); LRT_CALIBRATE sets it on T45.
    Meshing a calibrated bed again also probes its bed z with the BLTouch. With
    the reference tool in holder 45, tagged so, the reference points are taken
    again too (a full calibration); otherwise only the z is replaced, and tools
    probed after the move are off in XY by how far the bed moved.
    The RTP and FSR calibrations are split into probe_bed_z() and
    calibrate_reference() for this.
    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
    [limn.cfg]
2026-09-27 fix: put the tool away before every BLTouch probe of our own
    The panel z after a remesh relied on BED_MESH_CALIBRATE's UNDOCK having run
    just before; it undocks itself now. LRT_FSR_Z / LRT_FSR_EDGE probed an
    uncalibrated cell's BLTouch z with the tool on the carriage: they undock
    for it and take the tool back.
    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
2026-09-28 feat: fsr calibration
2026-09-29 feat: nih slicer + fsr fix
    [beds.py, fsr.py, geometry.py]
2026-09-29 add: tool handling
    [limn.cfg]
2026-09-30 feat: manual scanning
    [leds.cfg]
2026-09-30 feat: remove g1 hacks
    [limn.cfg]
2026-09-30 save drying pens
    [leds.cfg]
2026-09-30 camera scan
2026-10-01 feat: virtual led ui and manyh fixes to ux
2026-10-01 docs: changelog for 2026-10-01, UI screenshots; forms fit their panel
    The 2026.10.01 milestone: scanning for film (RAM + NAS, Hugin, flicker,
    corners), the plot UI over the canvas, the head and the LED display live.
    The Camera form no longer runs past its panel: the value column shrinks.
    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
2026-10-02 feat(plot): web UI finishing touches, layers, masks, drawing settings
    - A phone layout: the canvas on top, the panels under it, scrolled like a page.
    - Round colour buttons, palettes that line up; the Printer panel moved up with
    Tools and Display.
    - Klipper macro buttons (home, tool changes, calibration, bed mesh, lights) from
    the profile, only those Klipper has; "Fluidd at" for the cameras' addresses.
    - Drawing settings for every tool (speed, fills, stroke, bleed, too small, layers),
    overridable per tool; a colour's own fill and stroke settings left to its tool.
    - bleed: a gap kept from what another ink draws on top. layers: light inks go
    under darker ones, plotted light to dark.
    -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
2026-10-02 feat(guide): a static docs site from the STEP export
    guide/build.py: a page per design in the CAD (Blender shots, a 3D view, STEP and
    STL to download, where it is in Limn), the machine as a front view that names
    what is under the pointer, parts, bill of materials (Bambu Lab codes), videos,
    the build log (Hackaday posts and notebooks), and the story with the CAD over
    time. A dated zip of the printed parts. 3D models load only when asked.
    guide/export.py writes printables/ (each printed part's STEP and STL, parts.csv,
    README); guide/compare.py the version strips; guide/overnight.sh runs it all.
    guide/fusion/LimnMotion records the joints in Fusion; motion.py turns them into
    sliders in the 3D v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
    [parts.csv]
2026-10-03 move docs
    [parts.csv]
2026-10-07 fix camera
2026-10-07 proxy camera
    [limn.cfg]
2026-10-07 fix: press
    [limn.cfg]
2026-10-07 fix: bed
2026-10-07 feat: pen fsr calibration
2026-10-09 fsr: switch algorithm
2026-10-09 fix: fsr pull down
    [lrt_fsr_array.py]
2026-10-18 feat: kicad schematics and load cell
2026-10-26 load cell bed
2026-11-05 update schematics and add load cell test results
2026-11-06 klipper: K gear flipped, level-key unlock, single pushed lock on pickup
    This commit is AI Assisted
    `model: Claude Opus 5.5`, `tags: limn k-flip dock-pogo`
2026-11-06 klipper: K unlock checks its switch at the stop, K locks at half speed
    `model: Claude Opus 5.5`, `tags: limn k-unlock-check`
    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
2026-11-07 klipper: K back to the original direction, K_UNLOCK mirrors K_LOCK (no overdrive), both report the switch; no-tool sanity + K switch map; load-cell plan
    `model: Claude Opus 5.5`, `tags: k-axis, load-cell-plan, 2026-11-07`
    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
2026-11-07 ext: LIT in the extension (lit.py): force in printer.limn.lit, LIT_TARE/ARM/THRESHOLD, LIT_DEBUG lines, LIT_LOG with the toolhead's trapq position; macros for the UI
    `model: Claude Opus 5.5`, `tags: lit, load-cell, step-2, 2026-11-07`
    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
2026-11-08 klipper: K dir back to PB2, lock/unlock were reversed
    `model: Claude Opus 5.5`, `tags: k-axis, 2026-11-08`
    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
